drunkbatya/DrunkHeadphonesAdapter/hardware/d1/production/zip/bom.csv

Designator | Footprint | Quantity | Value | LCSC Part #
AUDIO1 | PJ-614 | 1 | PJ-614 | C145801
C10, C11, C12, C14, C15, C17, C18, C36, C38, C41, C42, C43, C45, C46, C47, C48, C6, C76, C8, C85, C93, C94 | CL05A105KA5NQNC | 22 | 1uF 25V X5R | C52923
C100, C101, C102, C103, C104, C105, C106, C107, C108, C53, C54, C55, C56, C69, C74, C77, C78, C79, C84, C86, C87, C88, C89, C90, C91, C92, C95, C96, C97, C98, C99 | 0402 | 31 | 100nF 50V | C307331
C13, C16, C2, C25, C3, C7 | 0603 | 6 | 2.2uF 16V | C23630
C19, C20, C21, C22 | 0402 | 4 | 1nF 50V | C1523
C24, C35, C37, C39, C40 | 0603 | 5 | 4.7uF 16V | C19666
C26, C27, C5, C75 | CL21A226MAQNNNE | 4 | 22uF 25V X5R | C45783
C28, C29, C30 | 0603 | 3 | 330pF 50V | C1664
C31, C32, C4 | CC0805KKX7R9BB225 | 3 | 2.2uF 50V X7R | C125847
C49 | 0402 | 1 | 10nF 50V X7R | C15195
C51, C57, C58, C59, C60, C61, C62, C9 | 1206 | 8 | 47uF 25V X5R | C76659
C64, C65, C67, C68 | 1206 | 4 | 2.2uF 50V X7R | C50254
D1, D2, D3 | D_SOD-123F | 3 | PMEG4010CEH_115 | C193342
D4 | TPD4E1B06DCKR | 1 | TPD4E1B06DCKR | C840093
L1, L3, L4, L5, L6 | BLM15AG601SN1D | 5 | BLM15AG601SN1D | C76884
L2 | SWPA4020S150MT | 1 | SWPA4020S150MT | C36407
L7, L8 | ECMF02-2AMX6 | 2 | ECMF02-2AMX6 | C2651144
Q1, Q2 | CSD17577Q3A | 2 | CSD17577Q3A | C201632
Q3 | SOT-523 | 1 | DMG1012T-7 | C20512
R1 | 1206 | 1 | 100Ω 1206 | C874066
R10, R13, R22, R29 | 0402 | 4 | 10kΩ | C25744
R11, R12 | 0402 | 2 | 2.2kΩ | C25879
R14, R15, R31, R32, R33, R34, R36, R37, R39, R4, R42, R5, R6, R7, R8 | 0402WGF1003TCE | 15 | 100kΩ | C25741
R16, R23, R9 | 0402 | 3 | 1kΩ | C11702
R18 | 0805 | 1 | 10mΩ 500mW | C409060
R19, R20 | 0603 | 2 | 549Ω | C23079
R2 | 0402WGF6202TCE | 1 | 62kΩ | C37825
R21, R28 | 0402 | 2 | 130kΩ | C93946
R24, R25, R26 | 0402 | 3 | 47kΩ | C25792
R27 | 0805 | 1 | 7mΩ 500mW | C22450691
R3 | 0402WGF2202TCE | 1 | 22kΩ | C25768
R30, R35 | 0603 | 2 | 10kΩ | C25804
R38, R43, R44 | 0402 | 3 | 33Ω | C25105
SW1 | SSSS811101 | 1 | SSSS811101 | C109335
SW3 | DSHP02TSGER | 1 | DSHP02TSGER | C3293142
TP1 | TestPoint_Pad_1.0x1.0mm | 1 | 3V3_D
TP2 | TestPoint_Pad_1.0x1.0mm | 1 | 1V8_D
TP3 | TestPoint_Pad_1.0x1.0mm | 1 | 1V8_CP
TP4 | TestPoint_Pad_1.0x1.0mm | 1 | 1V8_VA
TP5 | TestPoint_Pad_1.0x1.0mm | 1 | 3V3_VA
TP6 | TestPoint_Pad_1.0x1.0mm | 1 | 3V8
TP7 | TestPoint_Pad_1.0x1.0mm | 1 | PWR_IN
TP8 | TestPoint_Pad_1.0x1.0mm | 1 | GND
U1 | CS43131-CNZR | 1 | CS43131-CNZR | C965907
U10, U14 | BLM15PX601SN1D | 2 | BLM15PX601SN1D | C160977
U11, U8 | TPS7A2033PDBVR | 2 | TPS7A2033PDBVR | C2862740
U12, U13, U7 | TPS7A2018PDBVR | 3 | TPS7A2018PDBVR | C963430
U15, U16 | ESDA25P35-1U1M_C19829649 | 2 | ESDA25P35-1U1M | C19829649
U17 | SOT-23-5 | 1 | SN74LVC1G32DBVR | C10096
U18, U19 | TPS22917DBVR | 2 | TPS22917DBVR | C2681320
U2 | STM32G0B1VCT6 | 1 | STM32G0B1VCT6 | C3446137
U20 | SN74AVC4T774RSVR | 1 | SN74AVC4T774RSVR | C779392
U21 | TCA9406DCUR | 1 | TCA9406DCUR | C840107
U3 | TS3USB221RSER | 1 | TS3USB221RSER | C130085
U4, U5 | TCPP03-M20 | 2 | TCPP03-M20 | C3662955
U6 | ES8327 | 1 | ES8327 | C5145122
U9 | TPS560430XFDBVR | 1 | TPS560430XFDBVR | C523980
USB1 | 2130830005 | 1 | 2130830005 | C2839029
X1 | SX2M22_5792M20F30TNN | 1 | 22.5792MHz | C5452663
X3 | SX2M22_5792M20F30TNN | 1 | 24.576MHz | C5452664
