drunkbatya/DrunkHeadphonesAdapter/hardware/d1/DrunkEarPhoneAdapter.pdf

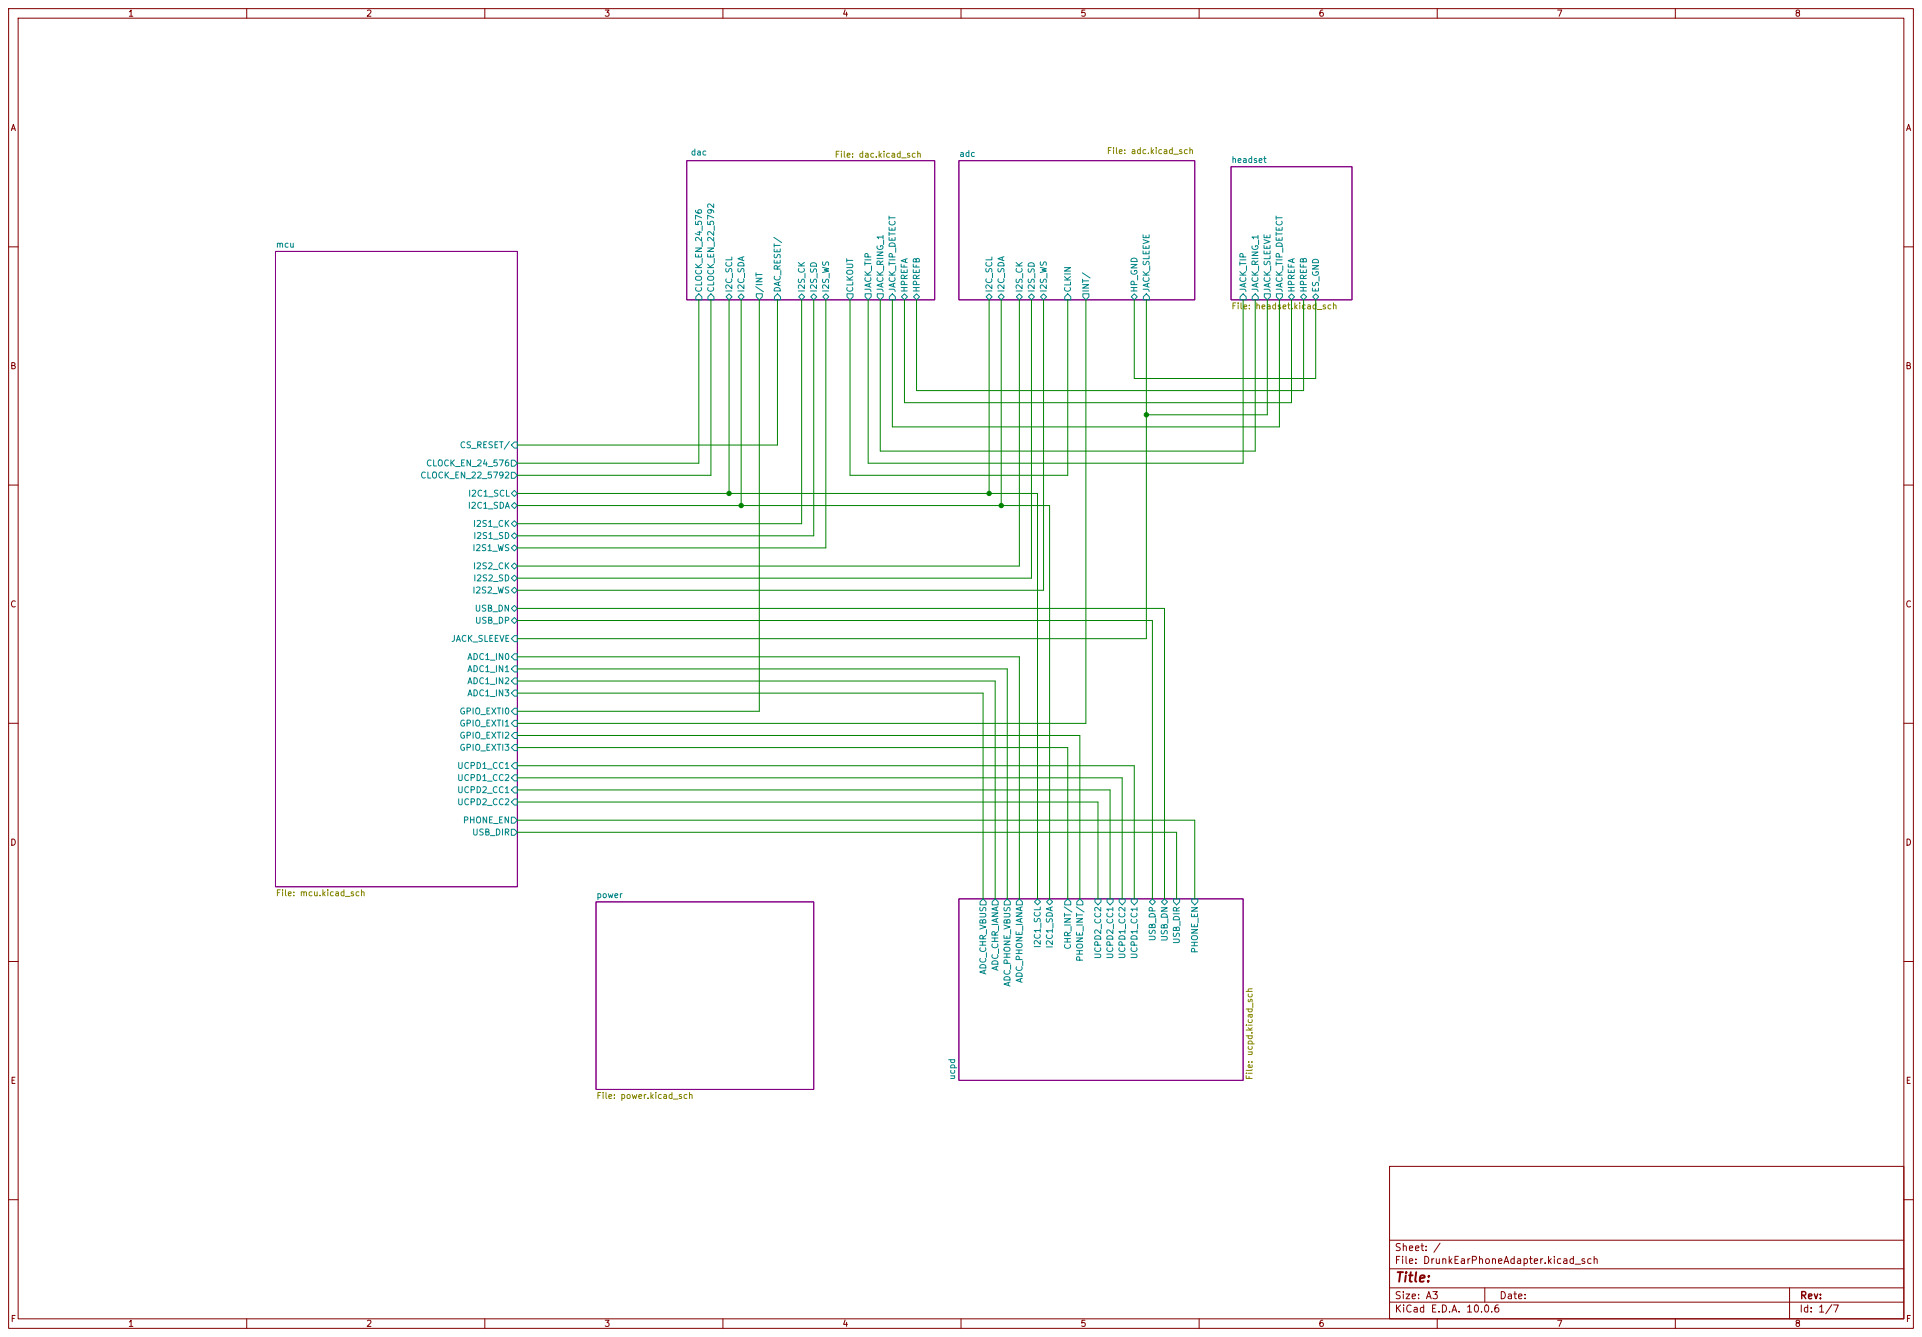
[picture p1: page 1]

Size: A3 | Rev: | F Date:
KiCad E.D.A. 10.0.6 | Id: 1/7

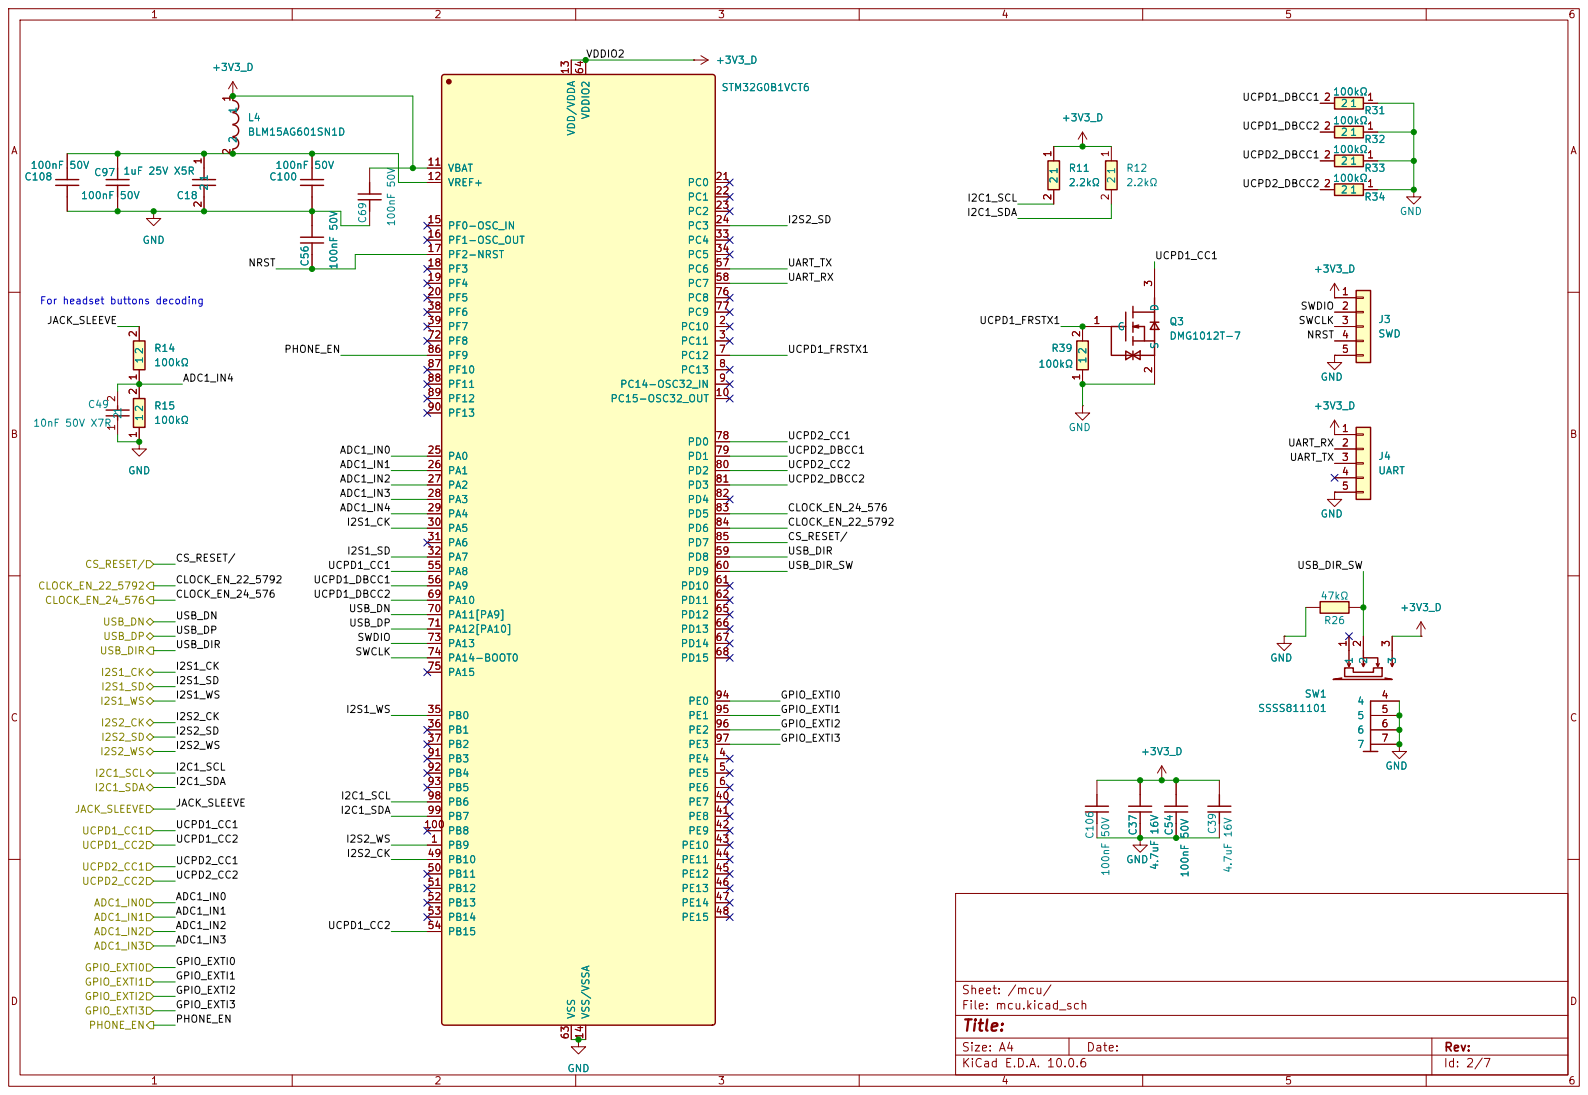
[picture p2: page 2]

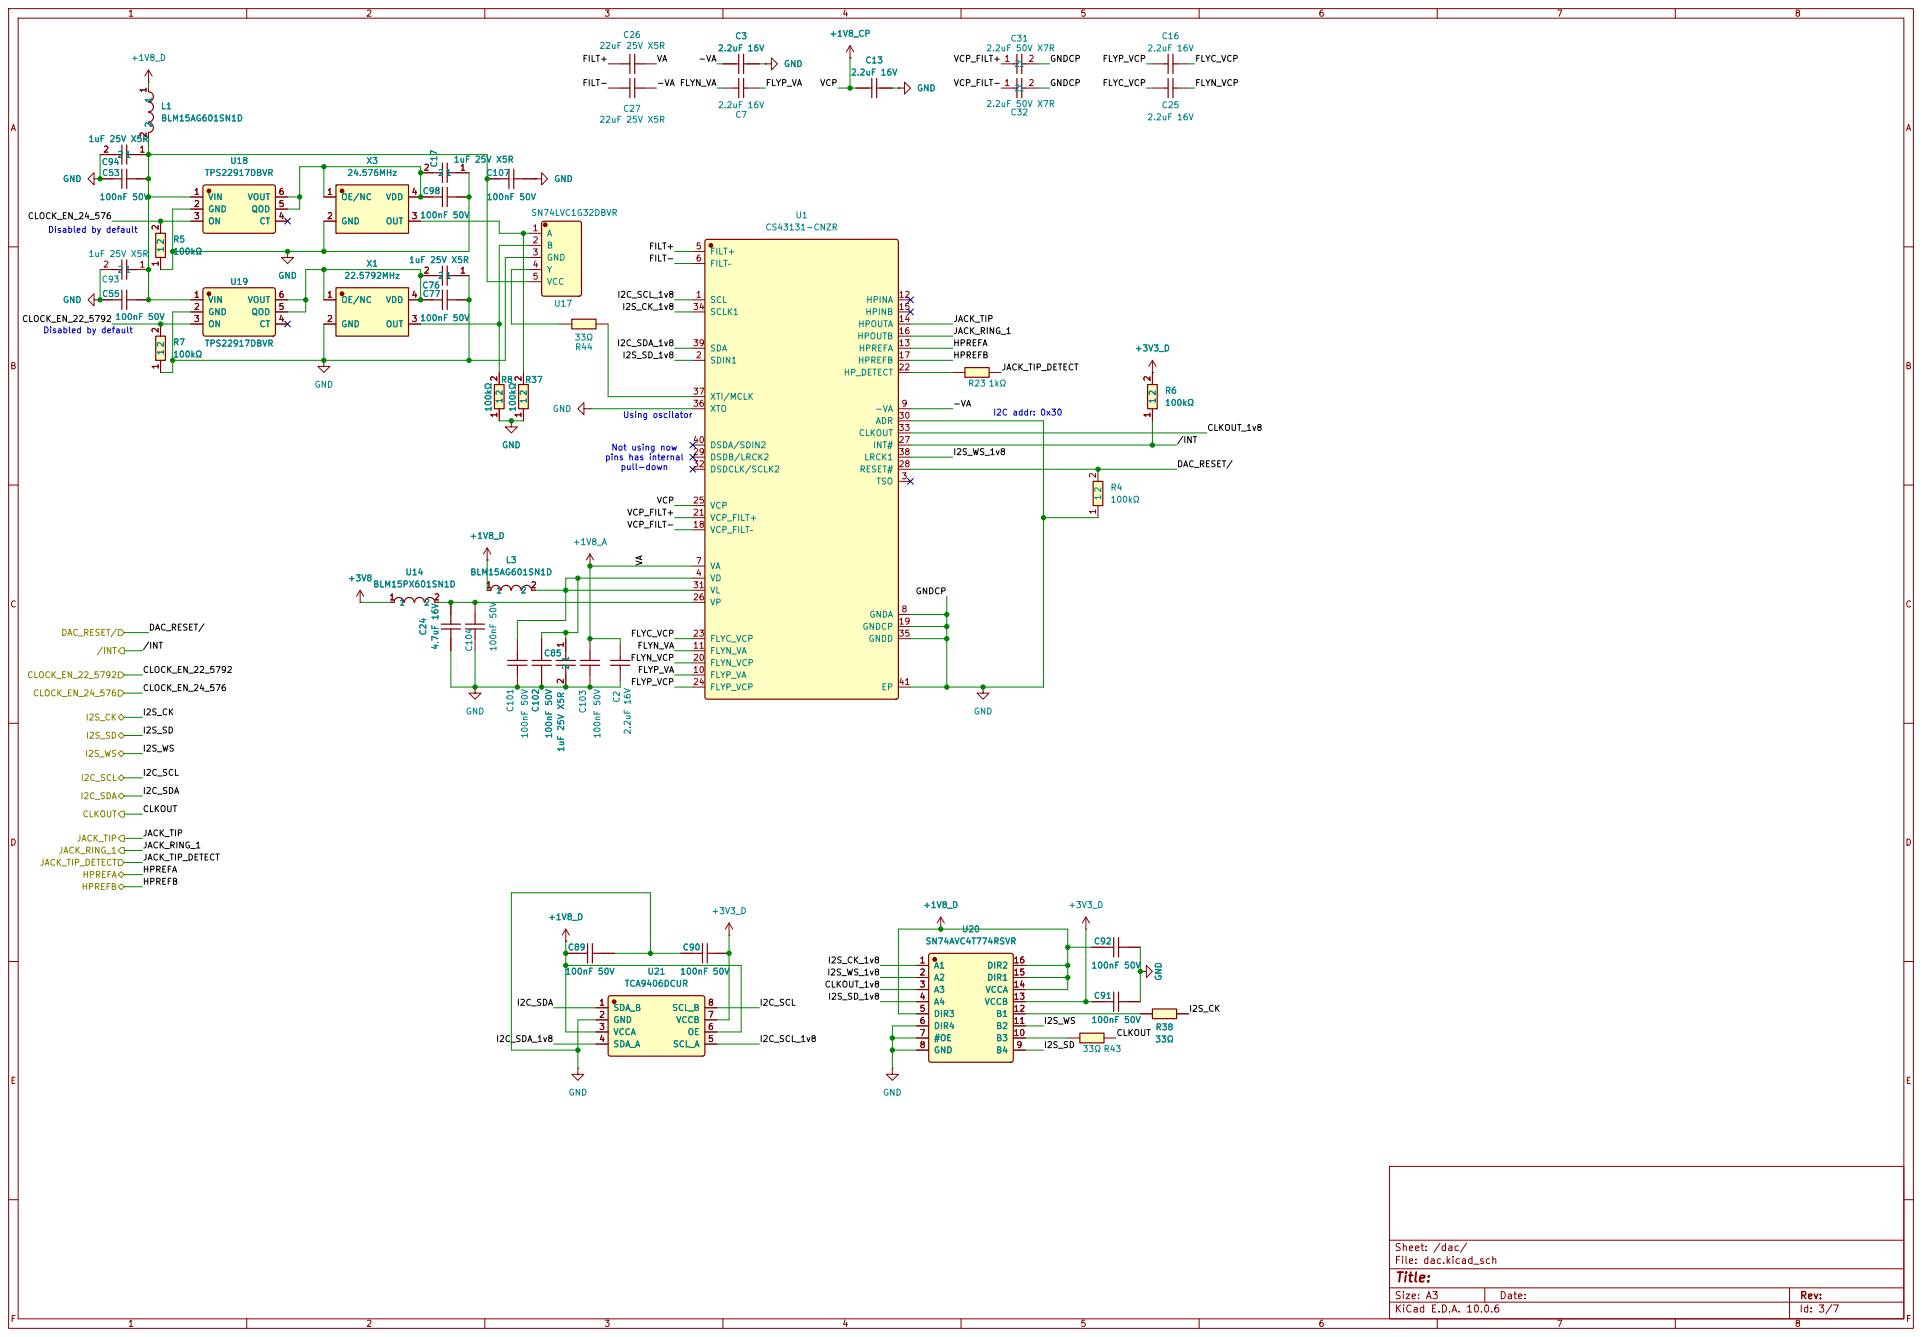
[picture p3: page 3]

pins has internal pull-down

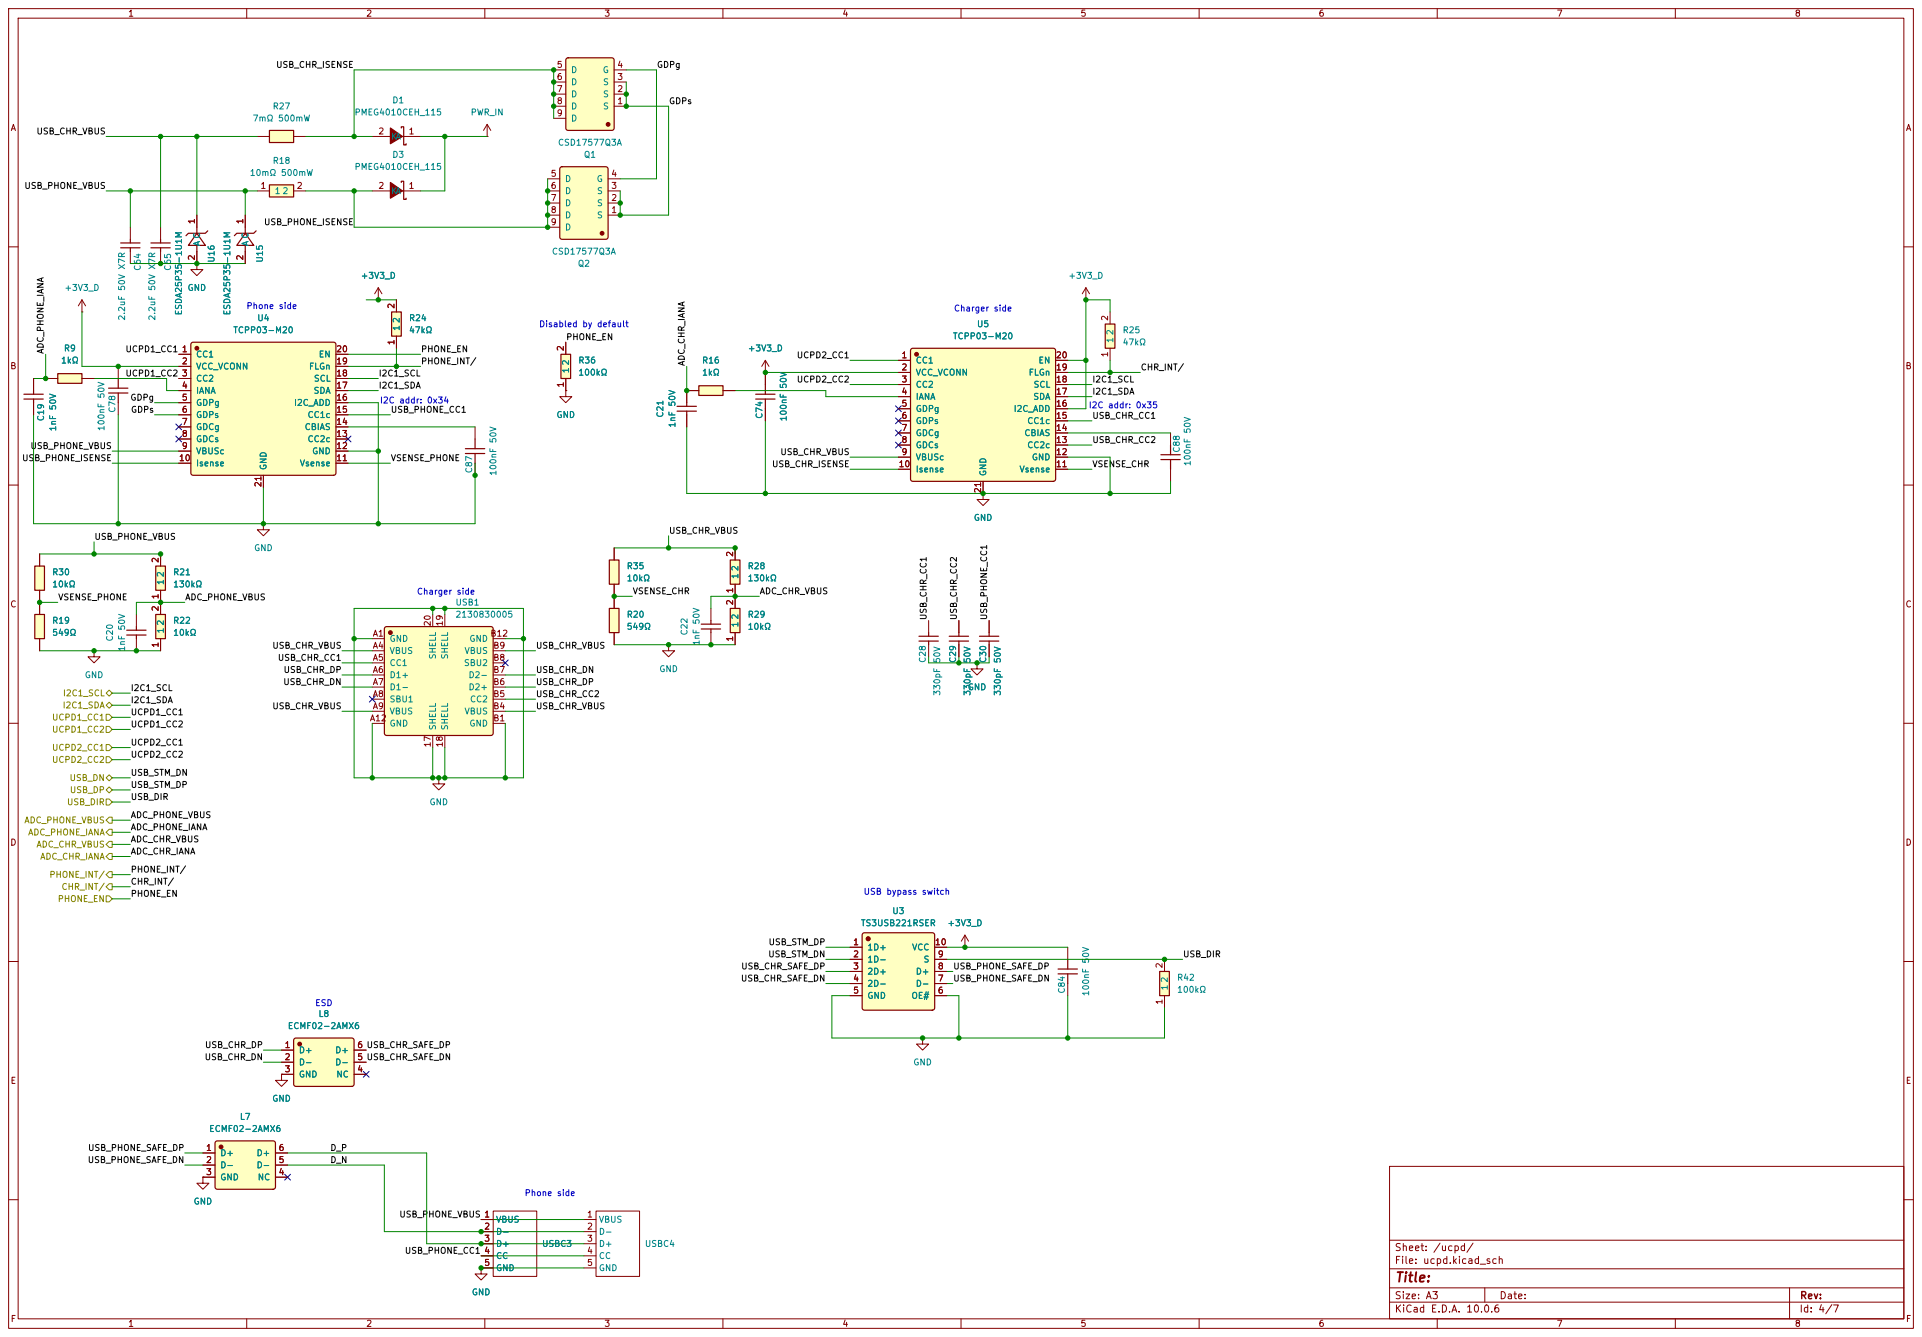
[picture p4: page 4]

Charger side Charger side Phone side

IANA 4 GDPg 5 GDPs 6 GDCg 7 GDCs 8

I2C addr: 0x35 USB bypass switch

VBUS 1 D- 2 D+ 3 CC 4 GND 5

USBC3

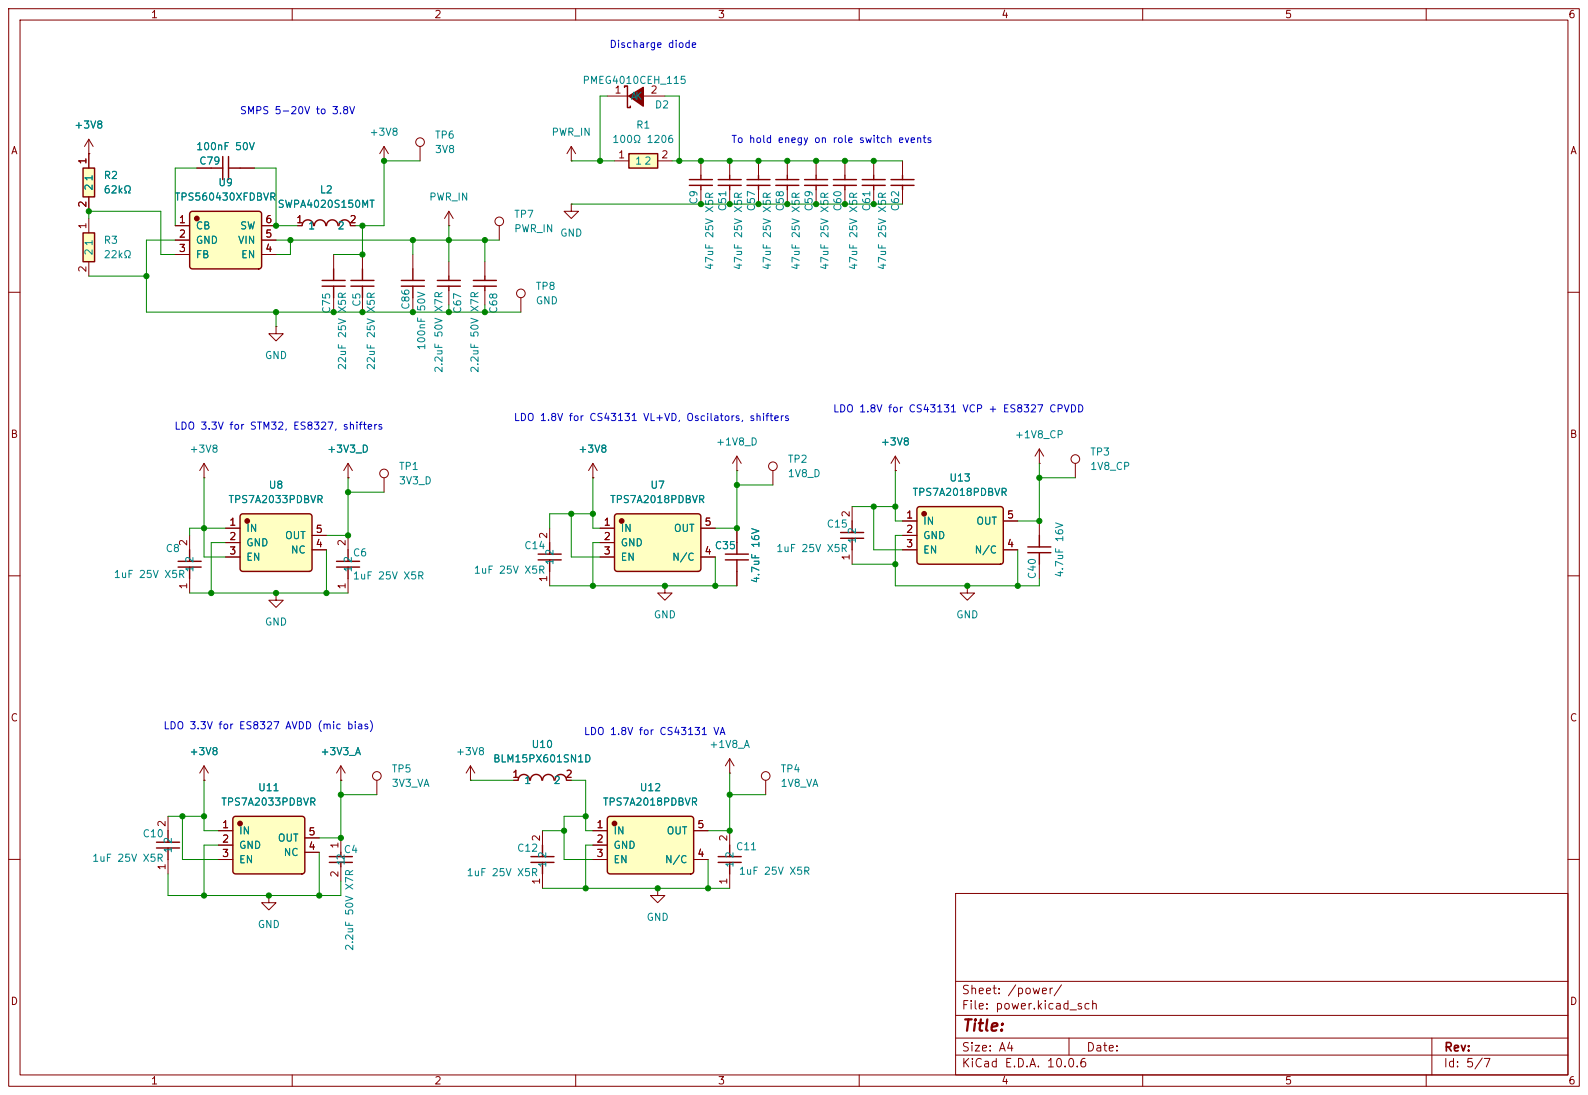
[picture p5: page 5]

LDO 1.8V for CS43131 VCP + ES8327 CPVDD

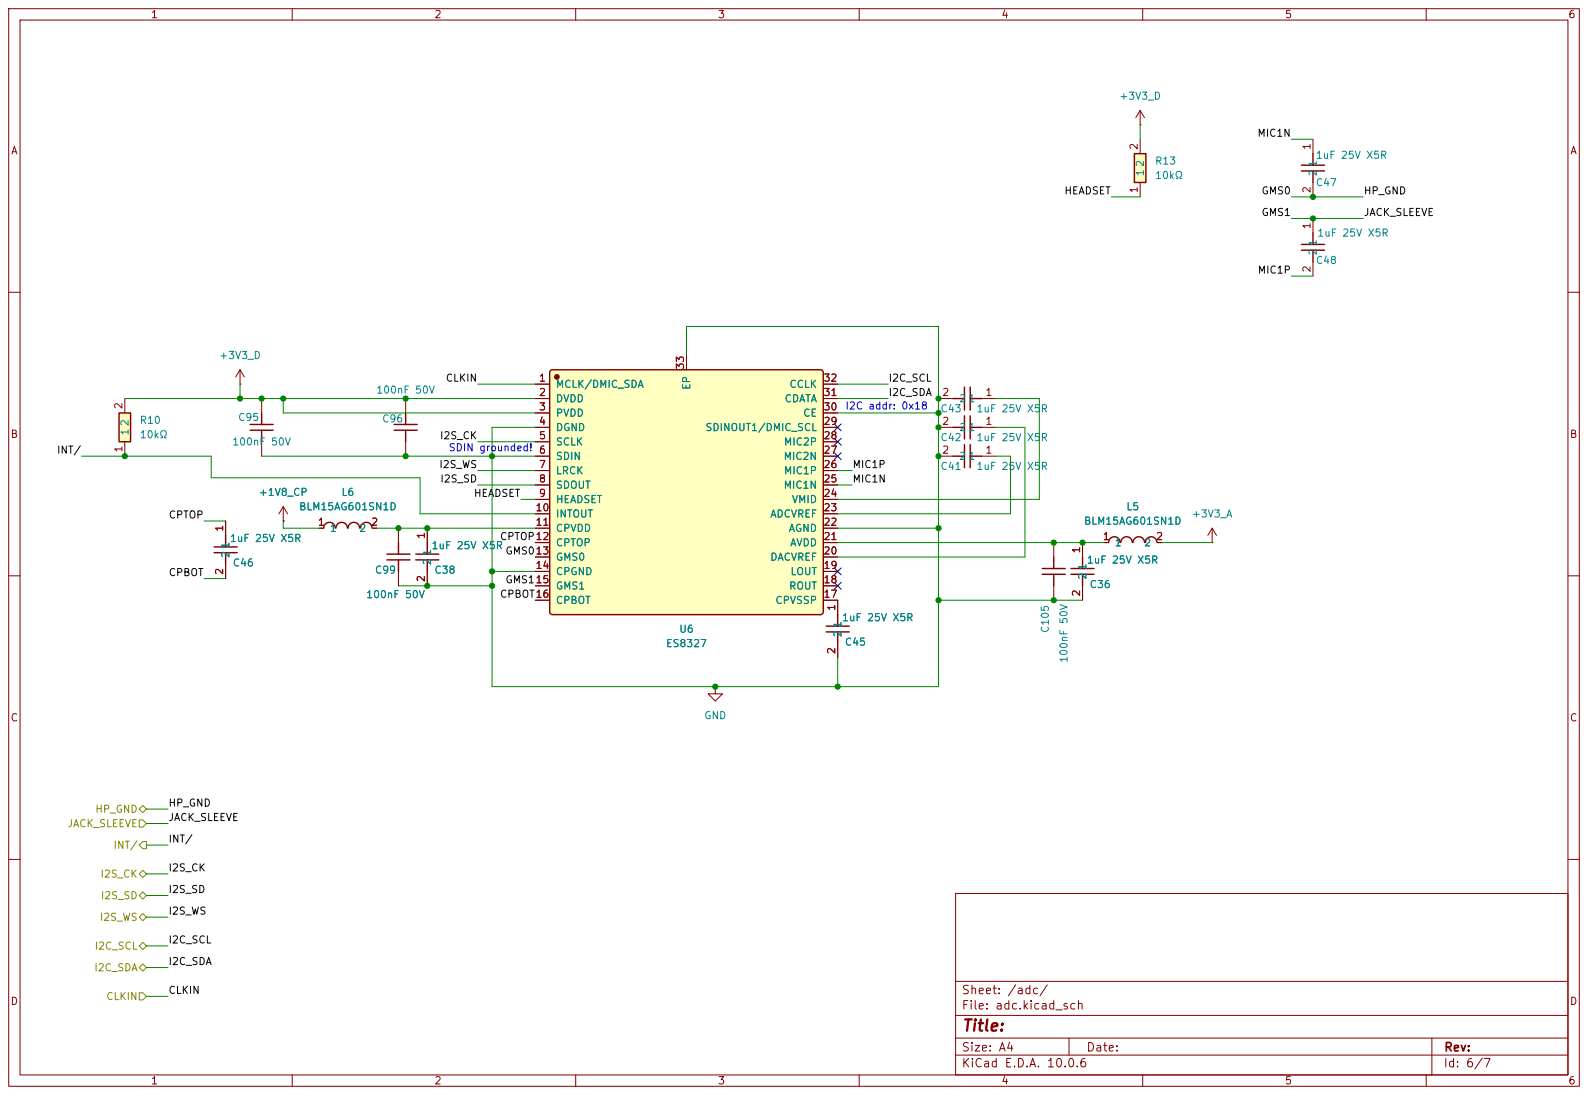
[picture p6: page 6]

MCLK/DMIC_SDA 1 DVDD 2 PVDD 3 DGND 4

ES8327 MCLK/DMIC_SDA 1 DVDD 2 PVDD 3 DGND 4

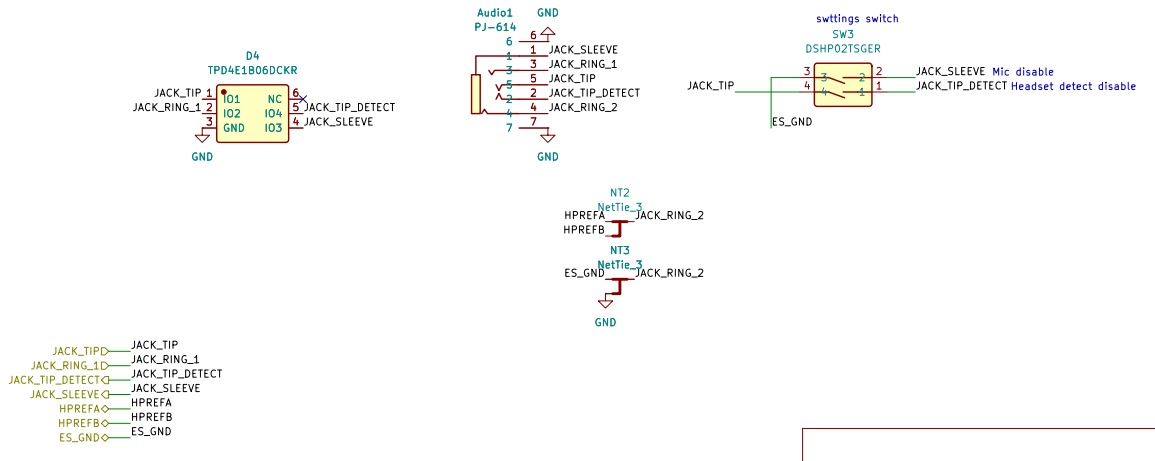
[picture p7: page 7]
