drunkbatya/DrunkHeadphonesAdapter/hardware/d1/DrunkEarPhoneAdapter.kicad_pcb

## KiCad design hardware/d1/DrunkEarPhoneAdapter.kicad_pcb (2026-11-13)

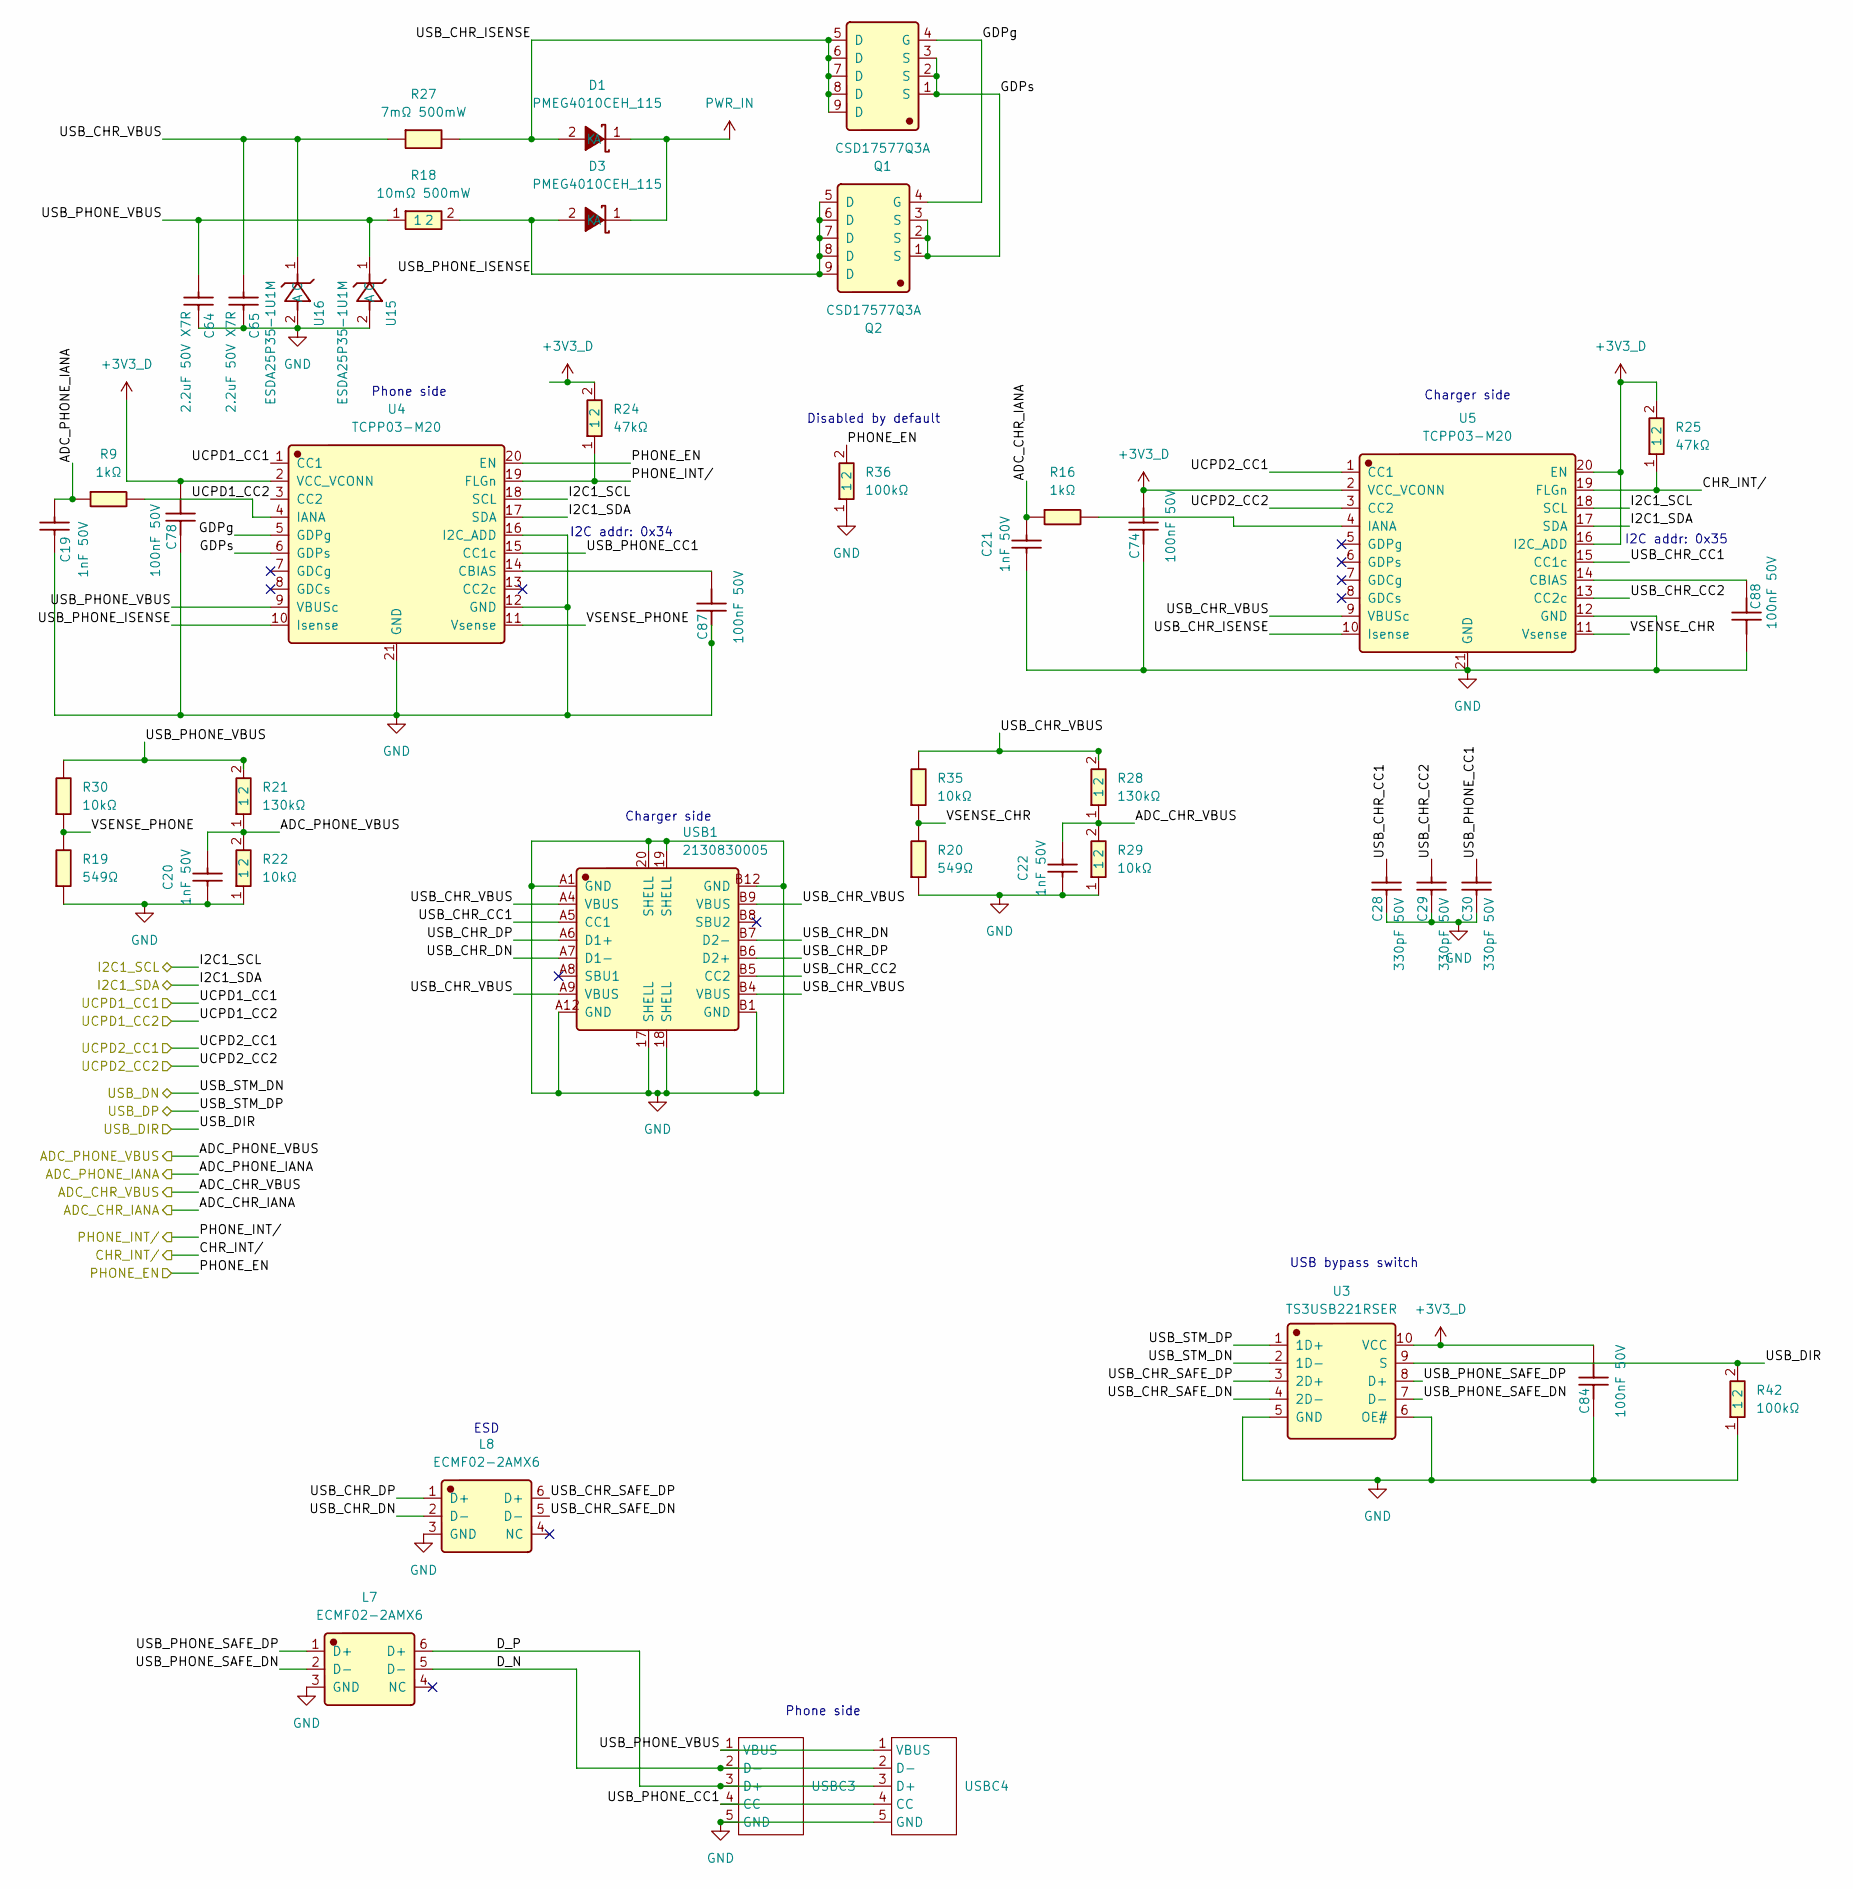
[picture p8: schematic ucpd.kicad_sch]

Parts:
C19, C20, C21, C22: 1nF 50V; C_0402_1005Metric; Manufacturer Part 0402B102K500NT; LCSC C1523
C28, C29, C30: 330pF 50V; C_0603_1608Metric; Manufacturer Part CL10C331JB8NNNC; LCSC C1664
C64, C65: 2.2uF 50V X7R; C_1206_3216Metric; Manufacturer Part CL31B225KBHNNNE; LCSC C50254
C74, C78, C84, C87, C88: 100nF 50V; C_0402_1005Metric; Manufacturer Part CL05B104KB54PNC; LCSC C307331
D1, D3: PMEG4010CEH_115; D_SOD-123F; Manufacturer Part PMEG4010CEH,115; LCSC C193342
L7, L8: ECMF02-2AMX6; Manufacturer Part ECMF02-2AMX6; LCSC C2651144
Q1, Q2: CSD17577Q3A; Manufacturer Part CSD17577Q3A; LCSC C201632
R9, R16: 1kΩ; R_0402_1005Metric; Manufacturer Part 0402WGF1001TCE; LCSC C11702
R18: 10mΩ 500mW; R_0805_2012Metric; Manufacturer Part ERJ6BWFR010V; LCSC C409060
R19, R20: 549Ω; R_0603_1608Metric; Manufacturer Part 0603WAF5490T5E; LCSC C23079
R21, R28: 130kΩ; R_0402_1005Metric; Manufacturer Part RC0402FR-07130KL; LCSC C93946
R22, R29: 10kΩ; R_0402_1005Metric; Manufacturer Part 0402WGF1002TCE; LCSC C25744
R24, R25: 47kΩ; R_0402_1005Metric; Manufacturer Part 0402WGF4702TCE; LCSC C25792
R27: 7mΩ 500mW; R_0805_2012Metric; Manufacturer Part HoYLR0805-1/2W-7mR-1%; LCSC C22450691
R30, R35: 10kΩ; R_0603_1608Metric; Manufacturer Part 0603WAF1002T5E; LCSC C25804
R36, R42: 100kΩ; 0402WGF1003TCE; Manufacturer Part 0402WGF1003TCE; LCSC C25741
U3: TS3USB221RSER; Manufacturer Part TS3USB221RSER; LCSC C130085
U4, U5: TCPP03-M20; Manufacturer Part TCPP03-M20; LCSC C3662955
U15, U16: ESDA25P35-1U1M; ESDA25P35-1U1M_C19829649; Manufacturer Part ESDA25P35-1U1M; LCSC C19829649
USB1: 2130830005; Manufacturer Part 2130830005; LCSC C2839029
USBC3, USBC4: USBC_EXT_5P

Connections:
+3V3_D: C74.2, C78.2, C84.2, R24.2, R25.2, U3.10 (VCC), U4.2 (VCC_VCONN), U5.2 (VCC_VCONN), U5.16 (I2C_ADD), U5.20 (EN); also elsewhere on the board
/adc/I2C_SCL: U4.18 (SCL), U5.18 (SCL); also elsewhere on the board
/adc/I2C_SDA: U4.17 (SDA), U5.17 (SDA); also elsewhere on the board
/mcu/ADC1_IN0: C19.2, R9.1; also elsewhere on the board
/mcu/ADC1_IN1: C20.2, R21.1, R22.2; also elsewhere on the board
/mcu/ADC1_IN2: C21.2, R16.1; also elsewhere on the board
/mcu/ADC1_IN3: C22.2, R28.1, R29.2; also elsewhere on the board
/mcu/GPIO_EXTI2: R24.1, U4.19 (FLGn); also elsewhere on the board
/mcu/GPIO_EXTI3: R25.1, U5.19 (FLGn); also elsewhere on the board
/mcu/PHONE_EN: R36.2, U4.20 (EN); also elsewhere on the board
/mcu/UCPD1_CC1: U4.1 (CC1); also elsewhere on the board
/mcu/UCPD1_CC2: U4.3 (CC2); also elsewhere on the board
/mcu/UCPD2_CC1: U5.1 (CC1); also elsewhere on the board
/mcu/UCPD2_CC2: U5.3 (CC2); also elsewhere on the board
/mcu/USB_DIR: R42.2, U3.9 (S); also elsewhere on the board
/mcu/USB_DN: U3.2 (1D-); also elsewhere on the board
/mcu/USB_DP: U3.1 (1D+); also elsewhere on the board
/ucpd/D_N: L7.5 (D-), USBC3.2 (D-), USBC4.2 (D-)
/ucpd/D_P: L7.6 (D+), USBC3.3 (D+), USBC4.3 (D+)
/ucpd/GDPg: Q1.4 (G), Q2.4 (G), U4.5 (GDPg)
/ucpd/GDPs: Q1.1 (S), Q1.2 (S), Q1.3 (S), Q2.1 (S), Q2.2 (S), Q2.3 (S), U4.6 (GDPs)
/ucpd/USB_CHR_CC1: C28.2, U5.15 (CC1c), USB1.A5 (CC1)
/ucpd/USB_CHR_CC2: C29.2, U5.13 (CC2c), USB1.B5 (CC2)
/ucpd/USB_CHR_DN: L8.2 (D-), USB1.A7 (D1-), USB1.B7 (D2-)
/ucpd/USB_CHR_DP: L8.1 (D+), USB1.A6 (D1+), USB1.B6 (D2+)
/ucpd/USB_CHR_ISENSE: D1.2 (A), Q1.5 (D), Q1.6 (D), Q1.7 (D), Q1.8 (D), Q1.9 (D), R27.2, U5.10 (Isense)
/ucpd/USB_CHR_SAFE_DN: L8.5 (D-), U3.4 (2D-)
/ucpd/USB_CHR_SAFE_DP: L8.6 (D+), U3.3 (2D+)
/ucpd/USB_CHR_VBUS: C65.2, R27.1, R28.2, R35.2, U5.9 (VBUSc), U16.1 (C), USB1.A4 (VBUS), USB1.A9 (VBUS), USB1.B4 (VBUS), USB1.B9 (VBUS)
/ucpd/USB_PHONE_CC1: C30.2, U4.15 (CC1c), USBC3.4 (CC), USBC4.4 (CC)
/ucpd/USB_PHONE_ISENSE: D3.2 (A), Q2.5 (D), Q2.6 (D), Q2.7 (D), Q2.8 (D), Q2.9 (D), R18.2, U4.10 (Isense)
/ucpd/USB_PHONE_SAFE_DN: L7.2 (D-), U3.7 (D-)
/ucpd/USB_PHONE_SAFE_DP: L7.1 (D+), U3.8 (D+)
/ucpd/USB_PHONE_VBUS: C64.2, R18.1, R21.2, R30.2, U4.9 (VBUSc), U15.1 (C), USBC3.1 (VBUS), USBC4.1 (VBUS)
/ucpd/VSENSE_CHR: R20.2, R35.1, U5.11 (Vsense)
/ucpd/VSENSE_PHONE: R19.2, R30.1, U4.11 (Vsense)
GND: C19.1, C20.1, C21.1, C22.1, C28.1, C29.1, C30.1, C64.1, C65.1, C74.1, C78.1, C84.1, C87.1, C88.2, L7.3 (GND), L8.3 (GND), R19.1, R20.1, R22.1, R29.1, R36.1, R42.1, U3.5 (GND), U3.6 (OE#), U4.12 (GND), U4.16 (I2C_ADD), U4.21 (GND), U5.12 (GND), U5.21 (GND), U15.2 (A), U16.2 (A), USB1.17 (SHELL), USB1.18 (SHELL), USB1.19 (SHELL), USB1.20 (SHELL), USB1.A1 (GND), USB1.A12 (GND), USB1.B1 (GND), USB1.B12 (GND), USBC3.5 (GND), USBC4.5 (GND); also elsewhere on the board
unnamed: C87.2, U4.14 (CBIAS)
unnamed: R9.2, U4.4 (IANA)
unnamed: C88.1, U5.14 (CBIAS)
unnamed: R16.2, U5.4 (IANA)
PWR_IN: D1.1 (K), D3.1 (K); also elsewhere on the board

Notes on the sheet:
I2C addr: 0x34
Charger side
I2C addr: 0x35
Disabled by default
USB bypass switch
Phone side
ESD

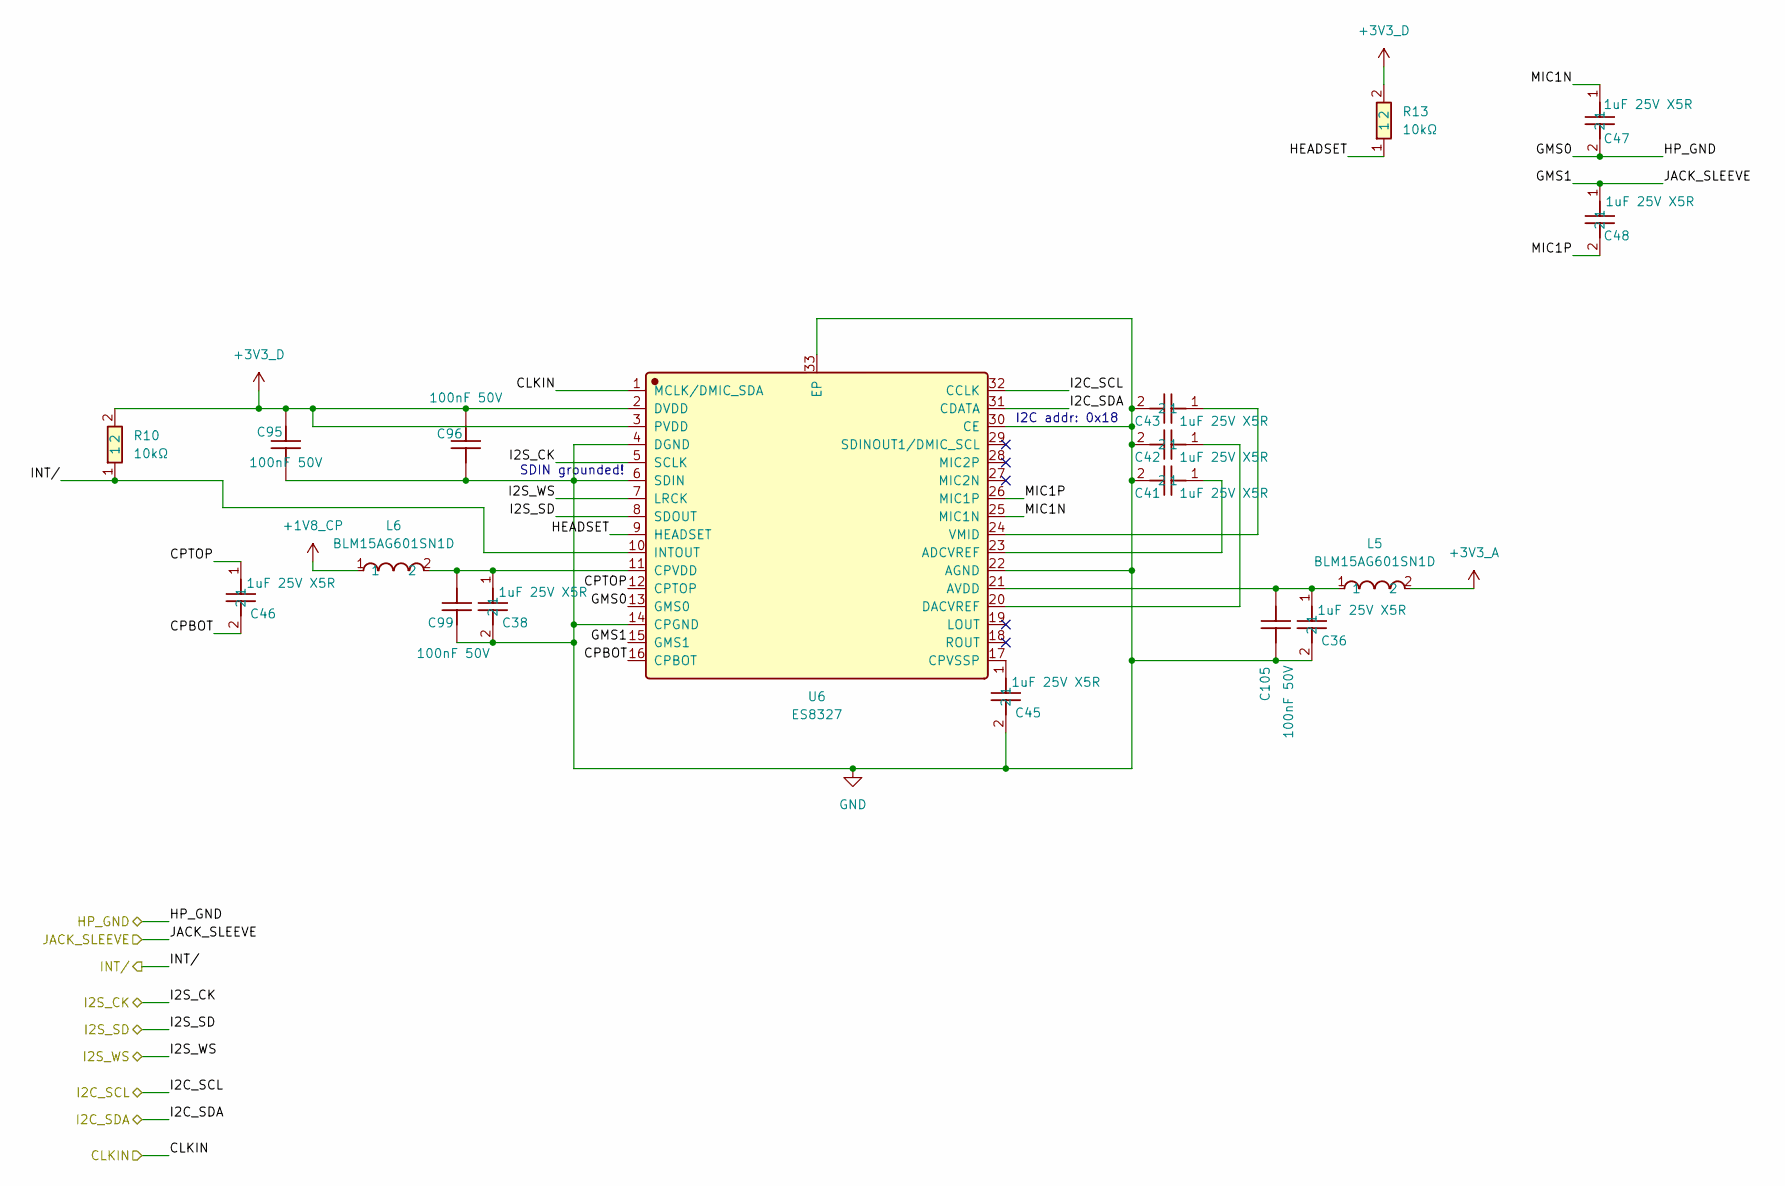
[picture p9: schematic adc.kicad_sch]

Parts:
C36, C38, C41, C42, C43, C45, C46, C47, C48: 1uF 25V X5R; CL05A105KA5NQNC; Manufacturer Part CL05A105KA5NQNC; LCSC C52923
C95, C96, C99, C105: 100nF 50V; C_0402_1005Metric; Manufacturer Part CL05B104KB54PNC; LCSC C307331
L5, L6: BLM15AG601SN1D; Manufacturer Part BLM15AG601SN1D; LCSC C76884
R10, R13: 10kΩ; R_0402_1005Metric; Manufacturer Part 0402WGF1002TCE; LCSC C25744
U6: ES8327; Manufacturer Part ES8327; LCSC C5145122

Connections:
+1V8_CP: L6.1; also elsewhere on the board
+3V3_A: L5.2; also elsewhere on the board
+3V3_D: C95.2, C96.2, R10.2, R13.2, U6.2 (DVDD), U6.3 (PVDD); also elsewhere on the board
/adc/CLKIN: U6.1 (MCLK/DMIC_SDA); also elsewhere on the board
/adc/CPBOT: C46.2, U6.16 (CPBOT)
/adc/CPTOP: C46.1, U6.12 (CPTOP)
/adc/GMS0: C47.2, U6.13 (GMS0); also elsewhere on the board
/adc/GMS1: C48.1, U6.15 (GMS1); also elsewhere on the board
/adc/HEADSET: R13.1, U6.9 (HEADSET)
/adc/I2C_SCL: U6.32 (CCLK); also elsewhere on the board
/adc/I2C_SDA: U6.31 (CDATA); also elsewhere on the board
/adc/I2S_CK: U6.5 (SCLK); also elsewhere on the board
/adc/I2S_SD: U6.8 (SDOUT); also elsewhere on the board
/adc/I2S_WS: U6.7 (LRCK); also elsewhere on the board
/adc/INT/: R10.1, U6.10 (INTOUT); also elsewhere on the board
/adc/MIC1N: C47.1, U6.25 (MIC1N)
/adc/MIC1P: C48.2, U6.26 (MIC1P)
GND: C36.2, C38.2, C41.2, C42.2, C43.2, C45.2, C95.1, C96.1, C99.1, C105.1, U6.4 (DGND), U6.6 (SDIN), U6.14 (CPGND), U6.22 (AGND), U6.30 (CE), U6.33 (EP); also elsewhere on the board
unnamed: C41.1, U6.23 (ADCVREF)
unnamed: C36.1, C105.2, L5.1, U6.21 (AVDD)
unnamed: C38.1, C99.2, L6.2, U6.11 (CPVDD)
unnamed: C45.1, U6.17 (CPVSSP)
unnamed: C42.1, U6.20 (DACVREF)
unnamed: C43.1, U6.24 (VMID)

Notes on the sheet:
SDIN grounded!
I2C addr: 0x18

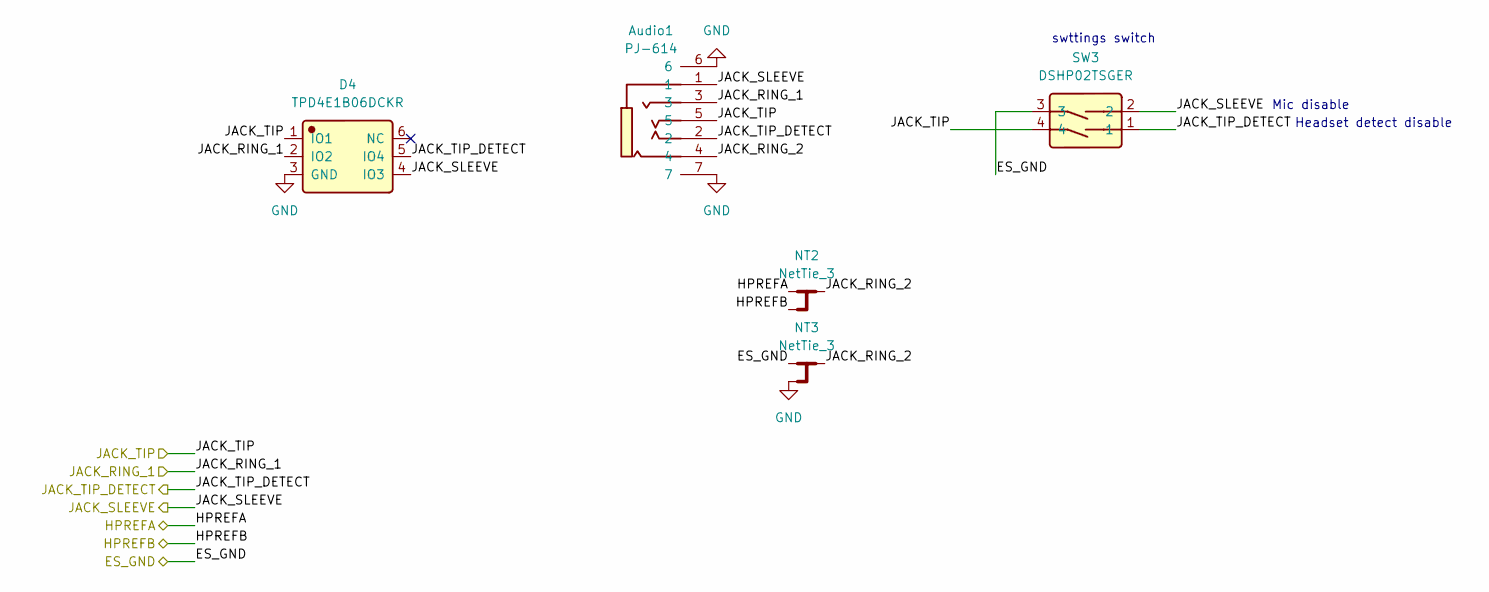
[picture p10: schematic headset.kicad_sch]

Parts:
Audio1: PJ-614; Manufacturer Part PJ-614; LCSC C145801
D4: TPD4E1B06DCKR; Manufacturer Part TPD4E1B06DCKR; LCSC C840093
NT2, NT3: NetTie_3; NetTie-3_SMD_Pad0.5mm
SW3: DSHP02TSGER; Manufacturer Part DSHP02TSGER; LCSC C3293142

Connections:
/adc/GMS0: NT3.1, SW3.3; also elsewhere on the board
/adc/GMS1: Audio1.1, D4.4 (IO3), SW3.2; also elsewhere on the board
/dac/HPREFA: NT2.1; also elsewhere on the board
/dac/HPREFB: NT2.3; also elsewhere on the board
/dac/JACK_RING_1: Audio1.3, D4.2 (IO2); also elsewhere on the board
/dac/JACK_TIP: Audio1.5, D4.1 (IO1), SW3.4; also elsewhere on the board
/dac/JACK_TIP_DETECT: Audio1.2, D4.5 (IO4), SW3.1; also elsewhere on the board
/headset/JACK_RING_2: Audio1.4, NT2.2, NT3.2
GND: Audio1.6, Audio1.7, D4.3 (GND), NT3.3; also elsewhere on the board

Notes on the sheet:
Headset detect disable
swttings switch
Mic disable

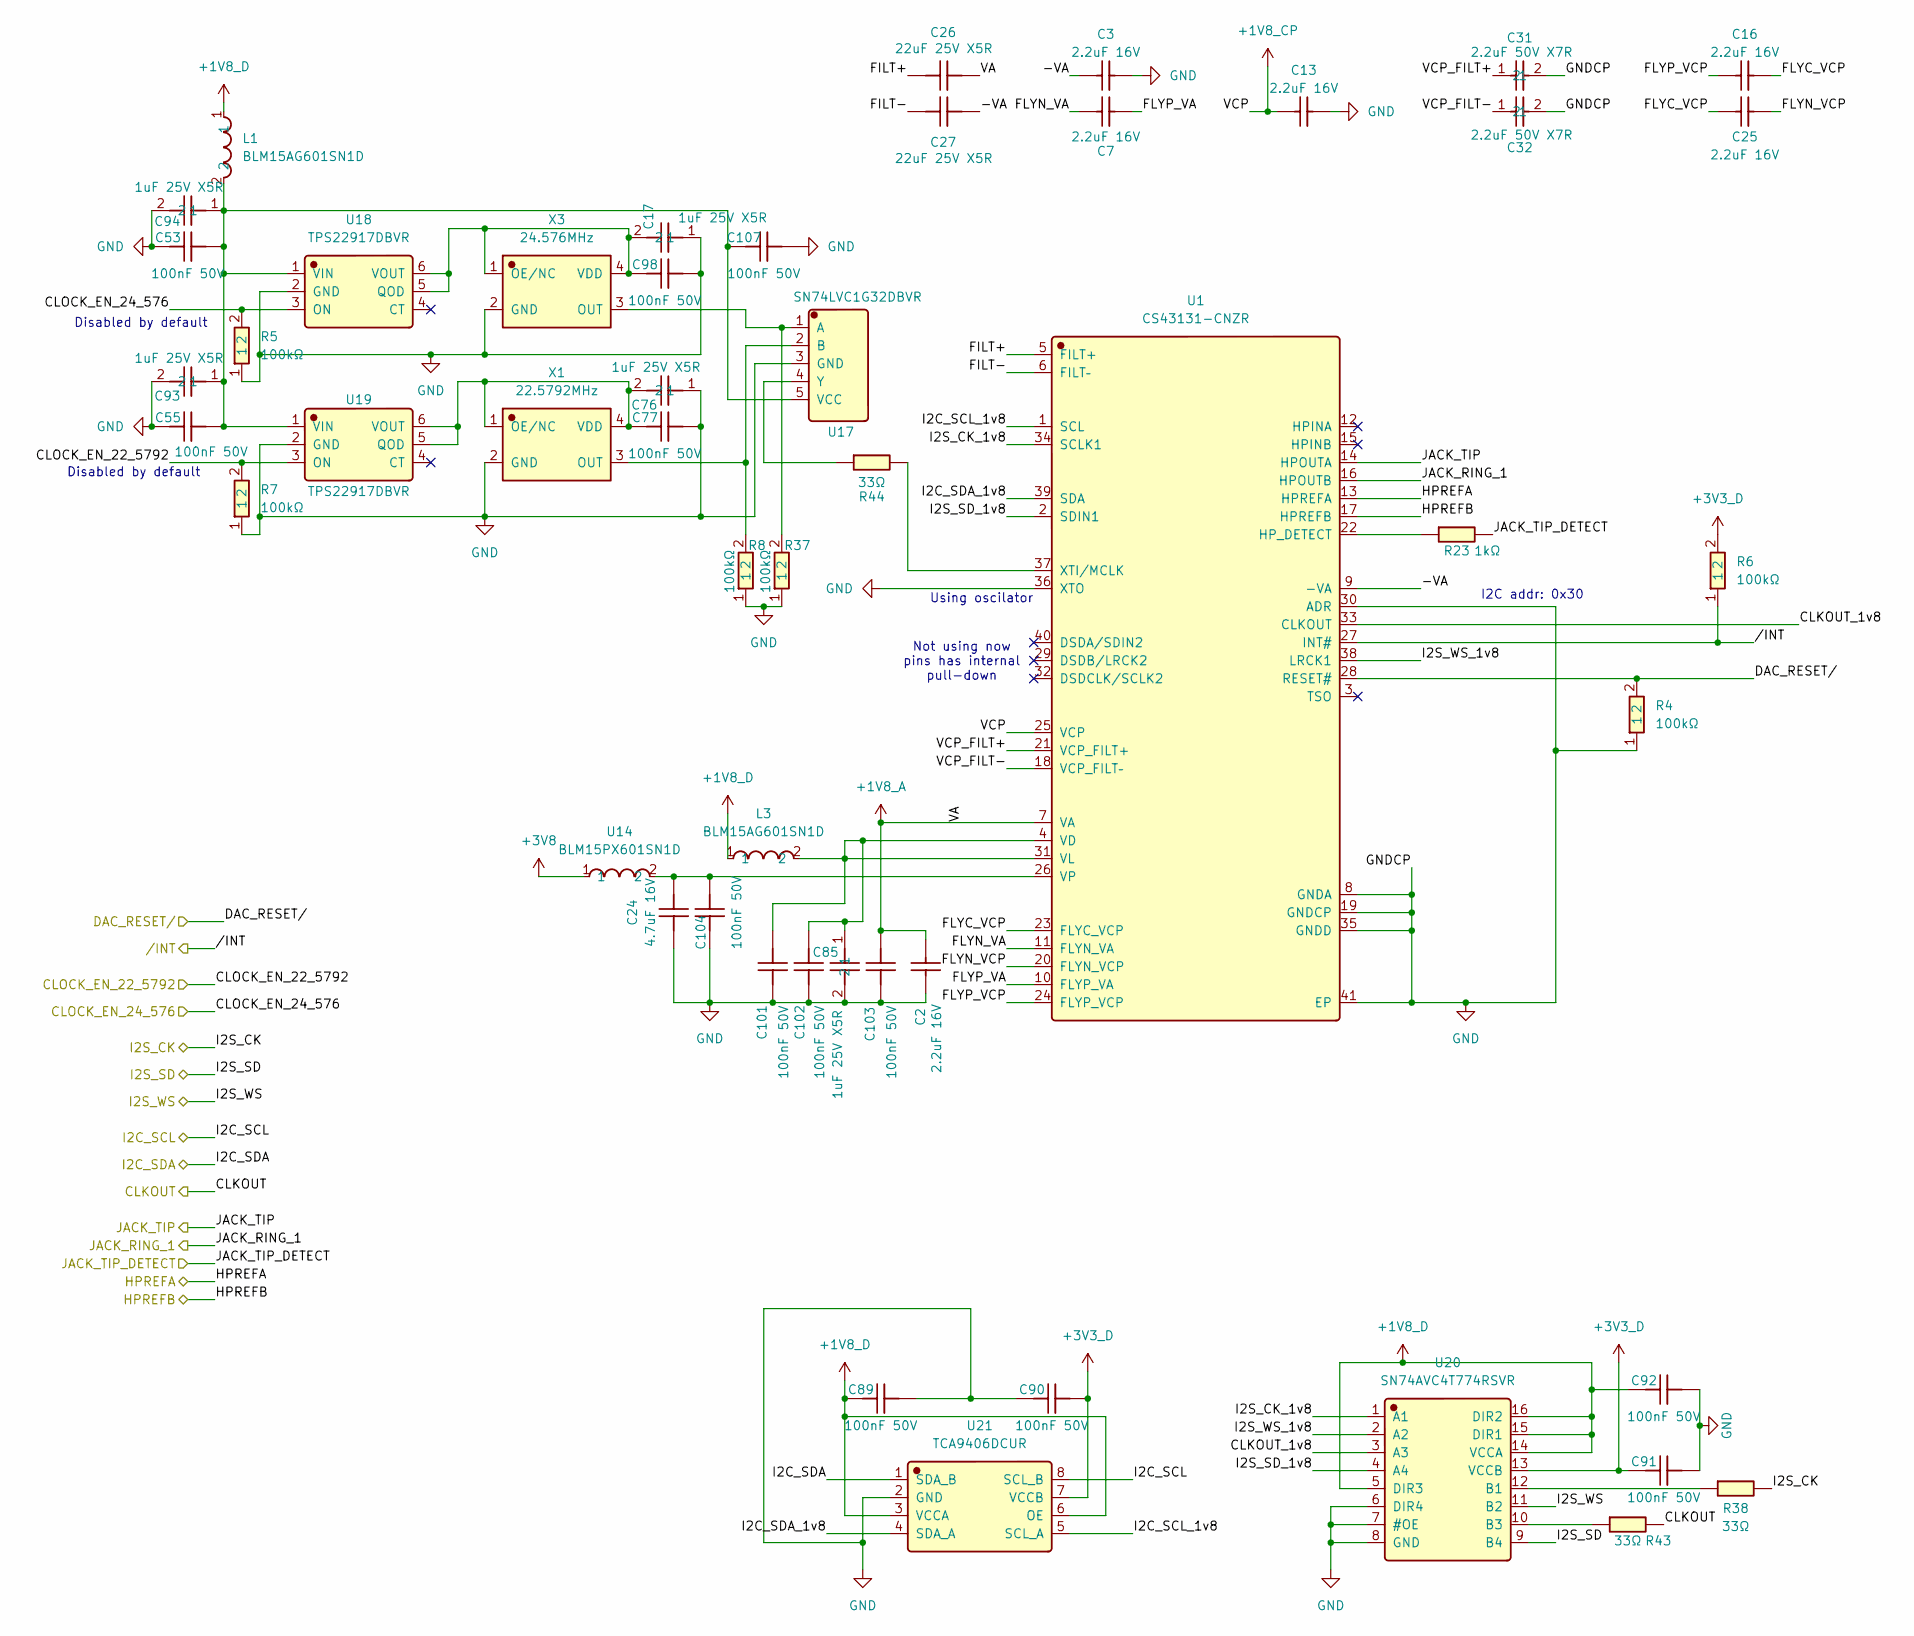
[picture p11: schematic dac.kicad_sch]

Parts:
C2, C3, C7, C13, C16, C25: 2.2uF 16V; C_0603_1608Metric; Manufacturer Part CL10A225KO8NNNC; LCSC C23630
C17, C76, C85, C93, C94: 1uF 25V X5R; CL05A105KA5NQNC; Manufacturer Part CL05A105KA5NQNC; LCSC C52923
C24: 4.7uF 16V; C_0603_1608Metric; Manufacturer Part CL10A475KO8NNNC; LCSC C19666
C26, C27: 22uF 25V X5R; CL21A226MAQNNNE; Manufacturer Part CL21A226MAQNNNE; LCSC C45783
C31, C32: 2.2uF 50V X7R; CC0805KKX7R9BB225; Manufacturer Part CC0805KKX7R9BB225; LCSC C125847
C53, C55, C77, C89, C90, C91, C92, C98, C101, C102, C103, C104, C107: 100nF 50V; C_0402_1005Metric; Manufacturer Part CL05B104KB54PNC; LCSC C307331
L1, L3: BLM15AG601SN1D; Manufacturer Part BLM15AG601SN1D; LCSC C76884
R4, R5, R6, R7, R8, R37: 100kΩ; 0402WGF1003TCE; Manufacturer Part 0402WGF1003TCE; LCSC C25741
R23: 1kΩ; R_0402_1005Metric; Manufacturer Part 0402WGF1001TCE; LCSC C11702
R38, R43, R44: 33Ω; R_0402_1005Metric; Manufacturer Part 0402WGF330JTCE; LCSC C25105
U1: CS43131-CNZR; Manufacturer Part CS43131-CNZR; LCSC C965907
U14: BLM15PX601SN1D; Manufacturer Part BLM15PX601SN1D; LCSC C160977
U17: SN74LVC1G32DBVR; SOT-23-5; Manufacturer Part SN74LVC1G32DBVR; LCSC C10096
U18, U19: TPS22917DBVR; Manufacturer Part TPS22917DBVR; LCSC C2681320
U20: SN74AVC4T774RSVR; Manufacturer Part SN74AVC4T774RSVR; LCSC C779392
U21: TCA9406DCUR; Manufacturer Part TCA9406DCUR; LCSC C840107
X1: 22.5792MHz; SX2M22_5792M20F30TNN; Manufacturer Part SX2M22.5792M20F30TNN; LCSC C5452663
X3: 24.576MHz; SX2M22_5792M20F30TNN; Manufacturer Part SX2M24.576M20F30TNN; LCSC C5452664

Connections:
+1V8_A: C2.2, C26.2, C103.2, U1.7 (VA); also elsewhere on the board
+1V8_CP: C13.1, U1.25 (VCP); also elsewhere on the board
+1V8_D: C89.1, C92.1, L1.1, L3.1, U20.5 (DIR3), U20.14 (VCCA), U20.15 (DIR1), U20.16 (DIR2), U21.3 (VCCA), U21.6 (OE); also elsewhere on the board
+3V3_D: C90.2, C91.1, R6.2, U20.13 (VCCB), U21.7 (VCCB); also elsewhere on the board
+3V8: U14.1; also elsewhere on the board
/adc/CLKIN: R43.2; also elsewhere on the board
/adc/I2C_SCL: U21.8 (SCL_B); also elsewhere on the board
/adc/I2C_SDA: U21.1 (SDA_B); also elsewhere on the board
/dac/-VA: C3.1, C27.2, U1.9 (-VA)
/dac/CLKOUT_1v8: U1.33 (CLKOUT), U20.3 (A3)
/dac/CLOCK_EN_22_5792: R7.2, U19.3 (ON); also elsewhere on the board
/dac/CLOCK_EN_24_576: R5.2, U18.3 (ON); also elsewhere on the board
/dac/DAC_RESET/: R4.2, U1.28 (RESET#); also elsewhere on the board
/dac/FILT+: C26.1, U1.5 (FILT+)
/dac/FILT-: C27.1, U1.6 (FILT–)
/dac/FLYC_VCP: C16.2, C25.1, U1.23 (FLYC_VCP)
/dac/FLYN_VA: C7.1, U1.11 (FLYN_VA)
/dac/FLYN_VCP: C25.2, U1.20 (FLYN_VCP)
/dac/FLYP_VA: C7.2, U1.10 (FLYP_VA)
/dac/FLYP_VCP: C16.1, U1.24 (FLYP_VCP)
/dac/HPREFA: U1.13 (HPREFA); also elsewhere on the board
/dac/HPREFB: U1.17 (HPREFB); also elsewhere on the board
/dac/I2C_SCL_1v8: U1.1 (SCL), U21.5 (SCL_A)
/dac/I2C_SDA_1v8: U1.39 (SDA), U21.4 (SDA_A)
/dac/I2S_CK: R38.2; also elsewhere on the board
/dac/I2S_CK_1v8: U1.34 (SCLK1), U20.1 (A1)
/dac/I2S_SD: U20.9 (B4); also elsewhere on the board
/dac/I2S_SD_1v8: U1.2 (SDIN1), U20.4 (A4)
/dac/I2S_WS: U20.11 (B2); also elsewhere on the board
/dac/I2S_WS_1v8: U1.38 (LRCK1), U20.2 (A2)
/dac/JACK_RING_1: U1.16 (HPOUTB); also elsewhere on the board
/dac/JACK_TIP: U1.14 (HPOUTA); also elsewhere on the board
/dac/JACK_TIP_DETECT: R23.2; also elsewhere on the board
/dac/VCP_FILT+: C31.1, U1.21 (VCP_FILT+)
/dac/VCP_FILT-: C32.1, U1.18 (VCP_FILT–)
/dac//INT: R6.1, U1.27 (INT#); also elsewhere on the board
GND: C2.1, C3.2, C13.2, C17.1, C24.1, C31.2, C32.2, C53.1, C55.1, C76.1, C77.2, C85.2, C89.2, C90.1, C91.2, C92.2, C93.2, C94.2, C98.2, C101.1, C102.1, C103.1, C104.1, C107.2, R4.1, R5.1, R7.1, R8.1, R37.1, U1.8 (GNDA), U1.19 (GNDCP), U1.30 (ADR), U1.35 (GNDD), U1.36 (XTO), U1.41 (EP), U17.3 (GND), U18.2 (GND), U19.2 (GND), U20.6 (DIR4), U20.7 (#OE), U20.8 (GND), U21.2 (GND), X1.2 (GND), X3.2 (GND); also elsewhere on the board
unnamed: R23.1, U1.22 (HP_DETECT)
unnamed: C85.1, C101.2, C102.2, L3.2, U1.4 (VD), U1.31 (VL)
unnamed: C24.2, C104.2, U1.26 (VP), U14.2
unnamed: R44.2, U1.37 (XTI/MCLK)
unnamed: R37.2, U17.1 (A), X3.3 (OUT)
unnamed: R8.2, U17.2 (B), X1.3 (OUT)
unnamed: C53.2, C55.2, C93.1, C94.1, C107.1, L1.2, U17.5 (VCC), U18.1 (VIN), U19.1 (VIN)
unnamed: R44.1, U17.4 (Y)
unnamed: C17.2, C98.1, U18.5 (QOD), U18.6 (VOUT), X3.1 (OE/NC), X3.4 (VDD)
unnamed: C76.2, C77.1, U19.5 (QOD), U19.6 (VOUT), X1.1 (OE/NC), X1.4 (VDD)
unnamed: R38.1, U20.12 (B1)
unnamed: R43.1, U20.10 (B3)

Notes on the sheet:
I2C addr: 0x30
Using oscilator
Not using now pins has internal pull-down
Disabled by default

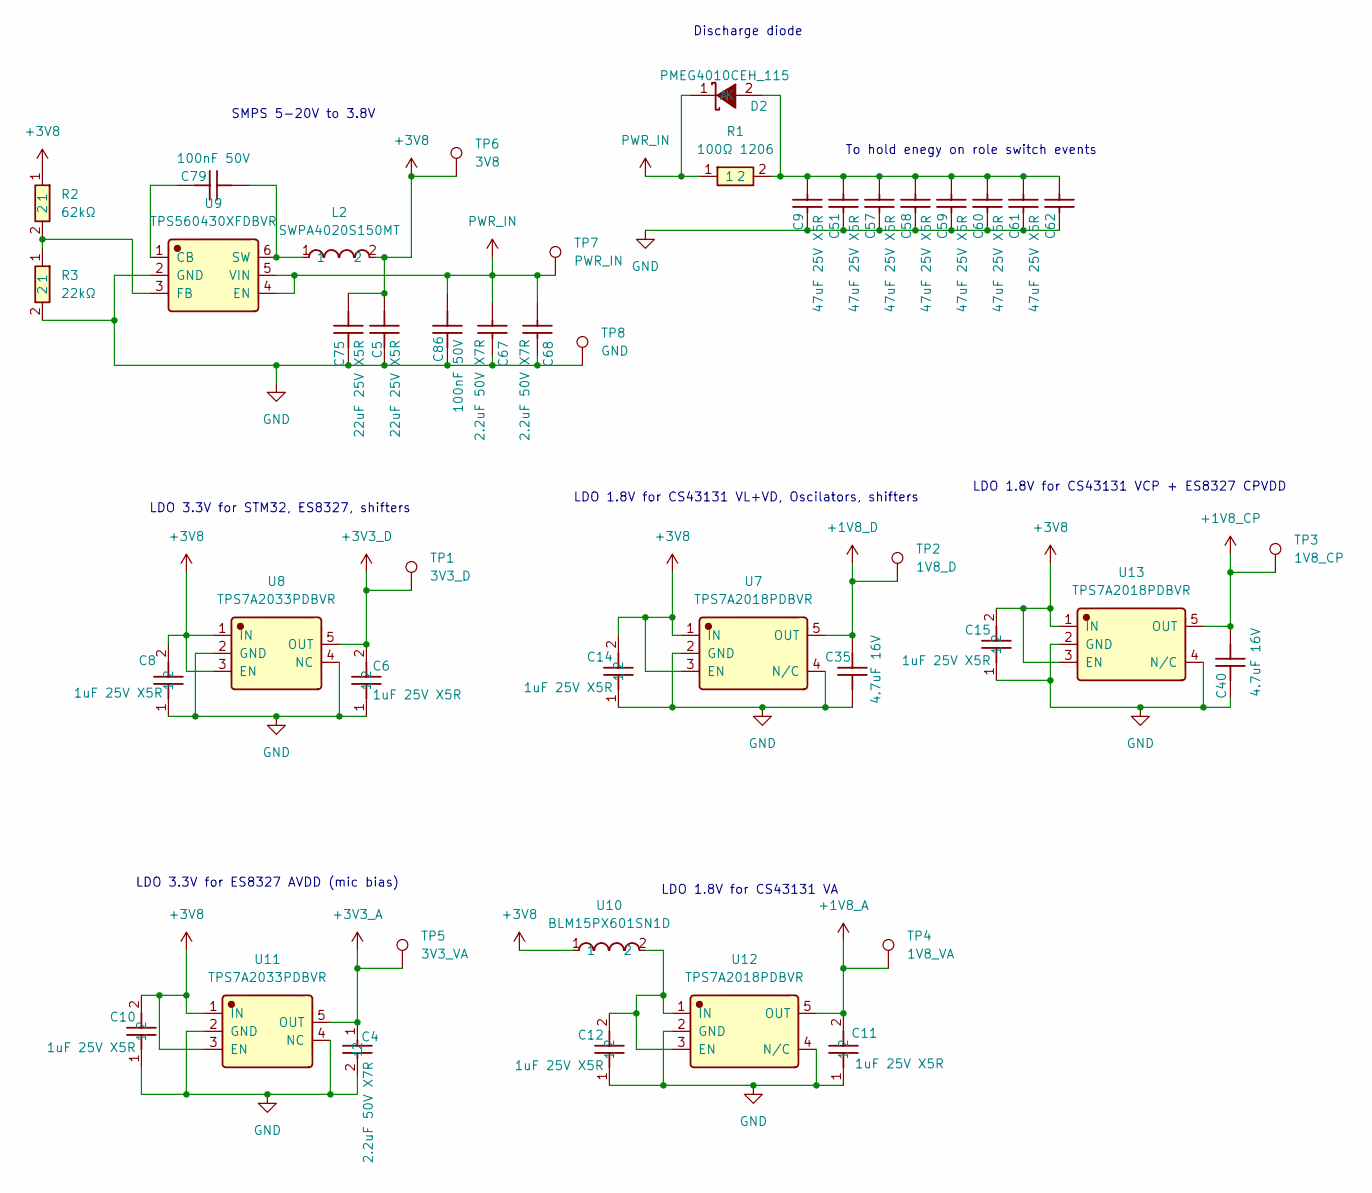
[picture p12: schematic power.kicad_sch]

Parts:
C4: 2.2uF 50V X7R; CC0805KKX7R9BB225; Manufacturer Part CC0805KKX7R9BB225; LCSC C125847
C5, C75: 22uF 25V X5R; CL21A226MAQNNNE; Manufacturer Part CL21A226MAQNNNE; LCSC C45783
C6, C8, C10, C11, C12, C14, C15: 1uF 25V X5R; CL05A105KA5NQNC; Manufacturer Part CL05A105KA5NQNC; LCSC C52923
C9, C51, C57, C58, C59, C60, C61, C62: 47uF 25V X5R; C_1206_3216Metric; Manufacturer Part C3216X5R1E476MTJ00E; LCSC C76659
C35, C40: 4.7uF 16V; C_0603_1608Metric; Manufacturer Part CL10A475KO8NNNC; LCSC C19666
C67, C68: 2.2uF 50V X7R; C_1206_3216Metric; Manufacturer Part CL31B225KBHNNNE; LCSC C50254
C79, C86: 100nF 50V; C_0402_1005Metric; Manufacturer Part CL05B104KB54PNC; LCSC C307331
D2: PMEG4010CEH_115; D_SOD-123F; Manufacturer Part PMEG4010CEH,115; LCSC C193342
L2: SWPA4020S150MT; Manufacturer Part SWPA4020S150MT; LCSC C36407
R1: 100Ω 1206; R_1206_3216Metric; Manufacturer Part SR1206JR-7W100RL; LCSC C874066
R2: 62kΩ; 0402WGF6202TCE; Manufacturer Part 0402WGF6202TCE; LCSC C37825
R3: 22kΩ; 0402WGF2202TCE; Manufacturer Part 0402WGF2202TCE; LCSC C25768
TP1: 3V3_D; TestPoint_Pad_1.0x1.0mm
TP2: 1V8_D; TestPoint_Pad_1.0x1.0mm
TP3: 1V8_CP; TestPoint_Pad_1.0x1.0mm
TP4: 1V8_VA; TestPoint_Pad_1.0x1.0mm
TP5: 3V3_VA; TestPoint_Pad_1.0x1.0mm
TP6: 3V8; TestPoint_Pad_1.0x1.0mm
TP7: PWR_IN; TestPoint_Pad_1.0x1.0mm
TP8: GND; TestPoint_Pad_1.0x1.0mm
U7, U12, U13: TPS7A2018PDBVR; Manufacturer Part TPS7A2018PDBVR; LCSC C963430
U8, U11: TPS7A2033PDBVR; Manufacturer Part TPS7A2033PDBVR; LCSC C2862740
U9: TPS560430XFDBVR; Manufacturer Part TPS560430XFDBVR; LCSC C523980
U10: BLM15PX601SN1D; Manufacturer Part BLM15PX601SN1D; LCSC C160977

Connections:
+1V8_A: C11.2, TP4.1 (1_1), U12.5 (OUT); also elsewhere on the board
+1V8_CP: C40.2, TP3.1 (1_1), U13.5 (OUT); also elsewhere on the board
+1V8_D: C35.2, TP2.1 (1_1), U7.5 (OUT); also elsewhere on the board
+3V3_A: C4.1, TP5.1 (1_1), U11.5 (OUT); also elsewhere on the board
+3V3_D: C6.2, TP1.1 (1_1), U8.5 (OUT); also elsewhere on the board
+3V8: C5.1, C8.2, C10.2, C14.2, C15.2, C75.1, L2.2, R2.1, TP6.1 (1_1), U7.1 (IN), U7.3 (EN), U8.1 (IN), U8.3 (EN), U10.1, U11.1 (IN), U11.3 (EN), U13.1 (IN), U13.3 (EN); also elsewhere on the board
GND: C4.2, C5.2, C6.1, C8.1, C9.1, C10.1, C11.1, C12.1, C14.1, C15.1, C35.1, C40.1, C51.1, C57.1, C58.1, C59.1, C60.1, C61.1, C62.1, C67.1, C68.1, C75.2, C86.1, R3.2, TP8.1 (1_1), U7.2 (GND), U7.4 (N/C), U8.2 (GND), U8.4 (NC), U9.2 (GND), U11.2 (GND), U11.4 (NC), U12.2 (GND), U12.4 (N/C), U13.2 (GND), U13.4 (N/C); also elsewhere on the board
unnamed: C9.2, C51.2, C57.2, C58.2, C59.2, C60.2, C61.2, C62.2, D2.2 (A), R1.2
unnamed: C79.1, U9.1 (CB)
unnamed: R2.2, R3.1, U9.3 (FB)
unnamed: C79.2, L2.1, U9.6 (SW)
unnamed: C12.2, U10.2, U12.1 (IN), U12.3 (EN)
PWR_IN: C67.2, C68.2, C86.2, D2.1 (K), R1.1, TP7.1 (1_1), U9.4 (EN), U9.5 (VIN); also elsewhere on the board

Notes on the sheet:
LDO 1.8V for CS43131 VCP + ES8327 CPVDD
LDO 3.3V for STM32, ES8327, shifters
To hold enegy on role switch events
LDO 3.3V for ES8327 AVDD (mic bias)
Discharge diode
LDO 1.8V for CS43131 VL+VD, Oscilators, shifters
LDO 1.8V for CS43131 VA
SMPS 5-20V to 3.8V
