drunkbatya/DrunkHeadphonesAdapter/hardware/d1/DrunkEarPhoneAdapter.kicad_pcb

## KiCad design hardware/d1/DrunkEarPhoneAdapter.kicad_pcb (continued)

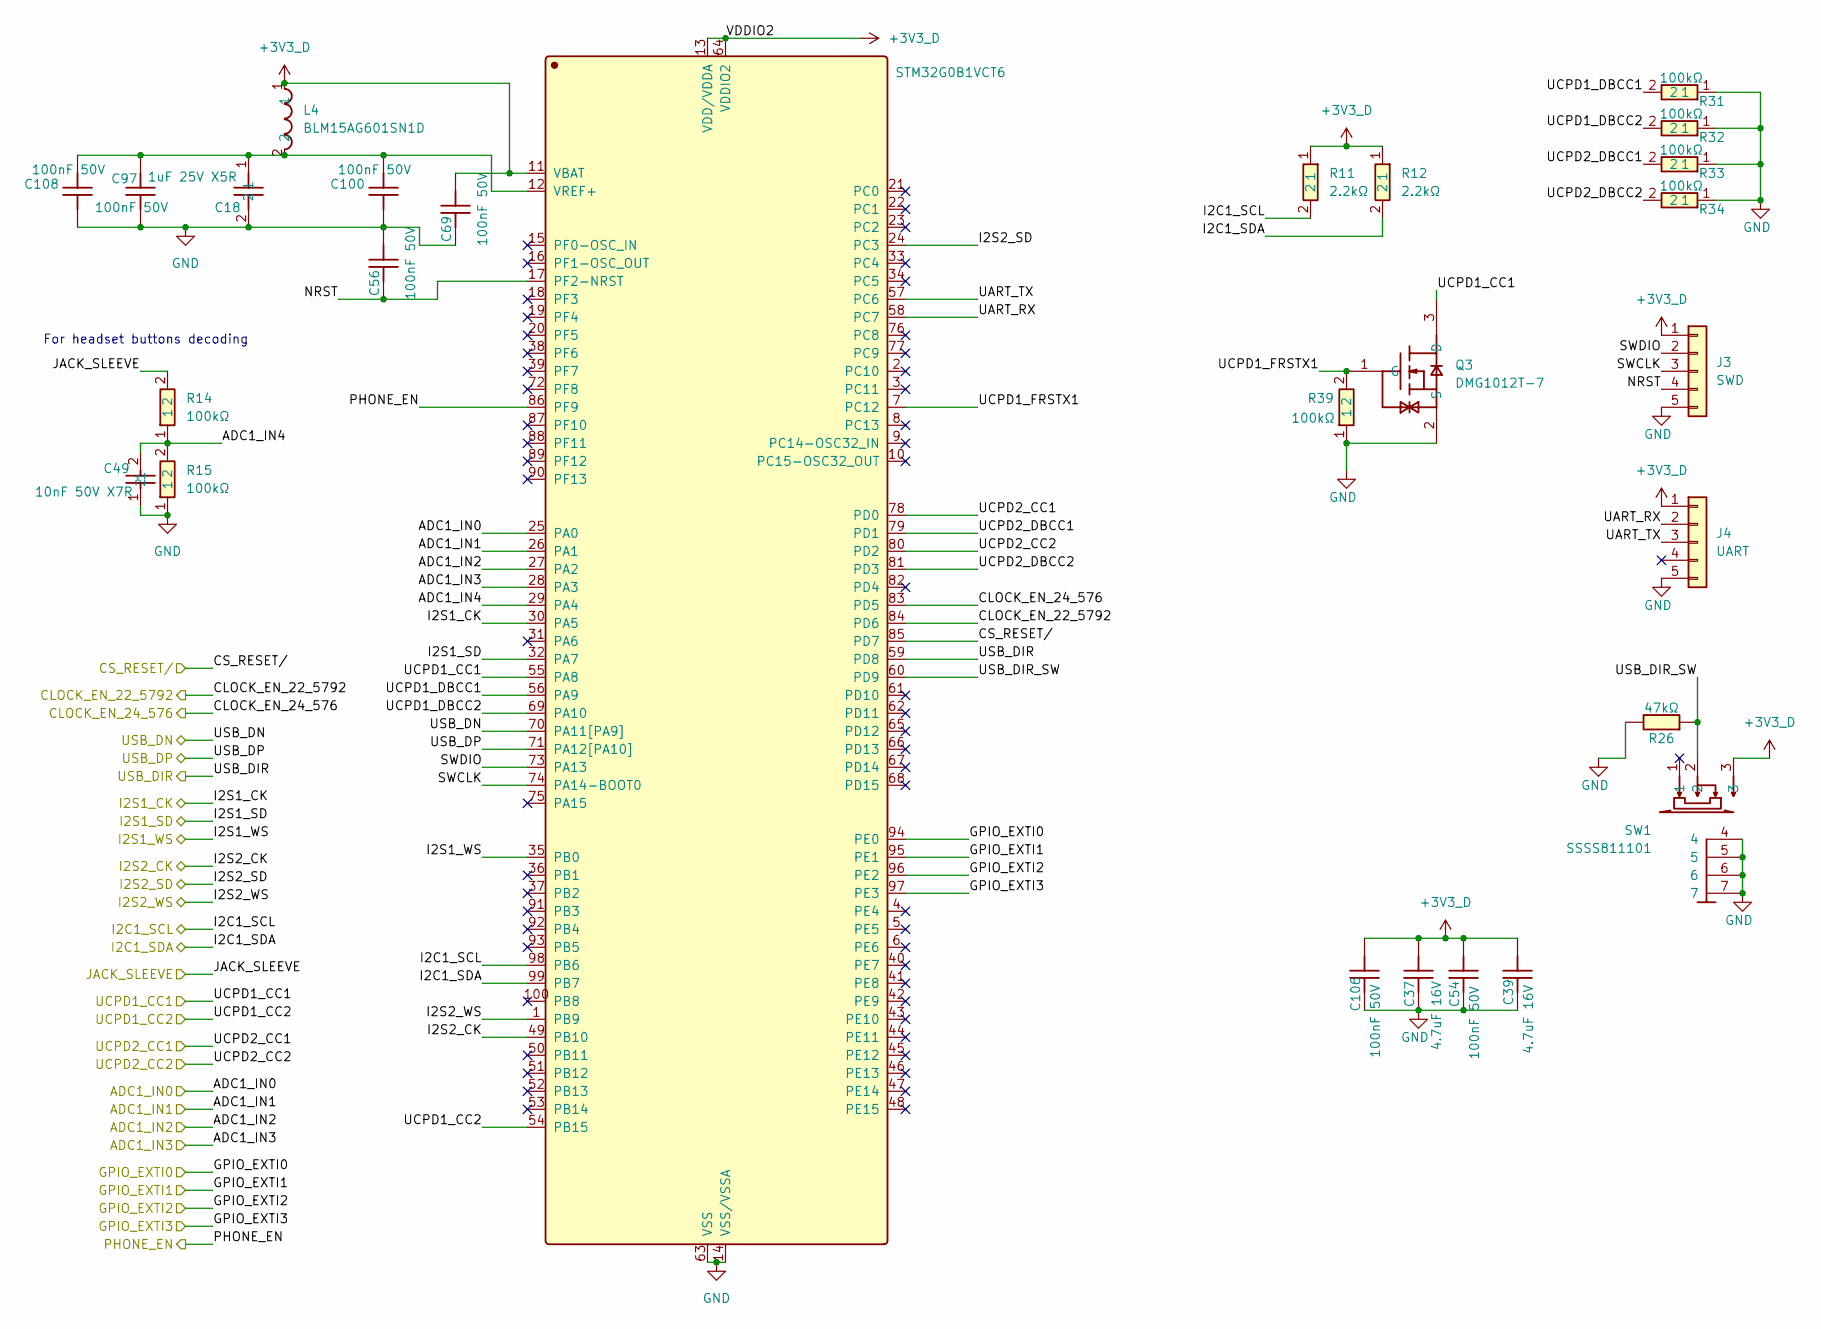
[picture p13: schematic mcu.kicad_sch]

Parts:
C18: 1uF 25V X5R; CL05A105KA5NQNC; Manufacturer Part CL05A105KA5NQNC; LCSC C52923
C37, C39: 4.7uF 16V; C_0603_1608Metric; Manufacturer Part CL10A475KO8NNNC; LCSC C19666
C49: 10nF 50V X7R; C_0402_1005Metric; Manufacturer Part CL05B103KB5NNNC; LCSC C15195
C54, C56, C69, C97, C100, C106, C108: 100nF 50V; C_0402_1005Metric; Manufacturer Part CL05B104KB54PNC; LCSC C307331
J3: SWD; Conn_1x5_1.27
J4: UART; Conn_1x5_1.27
L4: BLM15AG601SN1D; Manufacturer Part BLM15AG601SN1D; LCSC C76884
Q3: DMG1012T-7; SOT-523; Manufacturer Part DMG1012T-7; LCSC C20512
R11, R12: 2.2kΩ; R_0402_1005Metric; Manufacturer Part 0402WGF2201TCE; LCSC C25879
R14, R15, R31, R32, R33, R34, R39: 100kΩ; 0402WGF1003TCE; Manufacturer Part 0402WGF1003TCE; LCSC C25741
R26: 47kΩ; R_0402_1005Metric; Manufacturer Part 0402WGF4702TCE; LCSC C25792
SW1: SSSS811101; Manufacturer Part SSSS811101; LCSC C109335
U2: STM32G0B1VCT6; Manufacturer Part STM32G0B1VCT6; LCSC C3446137

Connections:
+3V3_D: C37.2, C39.2, C54.2, C69.2, C106.2, J3.1, J4.1, L4.1, R11.1, R12.1, SW1.3, U2.11 (VBAT), U2.13 (VDD/VDDA), U2.64 (VDDIO2); also elsewhere on the board
/adc/GMS1: R14.2; also elsewhere on the board
/adc/I2C_SCL: R11.2, U2.98 (PB6); also elsewhere on the board
/adc/I2C_SDA: R12.2, U2.99 (PB7); also elsewhere on the board
/adc/I2S_CK: U2.49 (PB10); also elsewhere on the board
/adc/I2S_SD: U2.24 (PC3); also elsewhere on the board
/adc/I2S_WS: U2.1 (PB9); also elsewhere on the board
/adc/INT/: U2.95 (PE1); also elsewhere on the board
/dac/CLOCK_EN_22_5792: U2.84 (PD6); also elsewhere on the board
/dac/CLOCK_EN_24_576: U2.83 (PD5); also elsewhere on the board
/dac/DAC_RESET/: U2.85 (PD7); also elsewhere on the board
/dac/I2S_CK: U2.30 (PA5); also elsewhere on the board
/dac/I2S_SD: U2.32 (PA7); also elsewhere on the board
/dac/I2S_WS: U2.35 (PB0); also elsewhere on the board
/dac//INT: U2.94 (PE0); also elsewhere on the board
/mcu/ADC1_IN0: U2.25 (PA0); also elsewhere on the board
/mcu/ADC1_IN1: U2.26 (PA1); also elsewhere on the board
/mcu/ADC1_IN2: U2.27 (PA2); also elsewhere on the board
/mcu/ADC1_IN3: U2.28 (PA3); also elsewhere on the board
/mcu/ADC1_IN4: C49.2, R14.1, R15.2, U2.29 (PA4)
/mcu/GPIO_EXTI2: U2.96 (PE2); also elsewhere on the board
/mcu/GPIO_EXTI3: U2.97 (PE3); also elsewhere on the board
/mcu/NRST: C56.1, J3.4, U2.17 (PF2-NRST)
/mcu/PHONE_EN: U2.86 (PF9); also elsewhere on the board
/mcu/SWCLK: J3.3, U2.74 (PA14-BOOT0)
/mcu/SWDIO: J3.2, U2.73 (PA13)
/mcu/UART_RX: J4.2, U2.58 (PC7)
/mcu/UART_TX: J4.3, U2.57 (PC6)
/mcu/UCPD1_CC1: Q3.3 (D), U2.55 (PA8); also elsewhere on the board
/mcu/UCPD1_CC2: U2.54 (PB15); also elsewhere on the board
/mcu/UCPD1_DBCC1: R31.2, U2.56 (PA9)
/mcu/UCPD1_DBCC2: R32.2, U2.69 (PA10)
/mcu/UCPD1_FRSTX1: Q3.1 (G), R39.2, U2.7 (PC12)
/mcu/UCPD2_CC1: U2.78 (PD0); also elsewhere on the board
/mcu/UCPD2_CC2: U2.80 (PD2); also elsewhere on the board
/mcu/UCPD2_DBCC1: R33.2, U2.79 (PD1)
/mcu/UCPD2_DBCC2: R34.2, U2.81 (PD3)
/mcu/USB_DIR: U2.59 (PD8); also elsewhere on the board
/mcu/USB_DIR_SW: R26.1, SW1.2, U2.60 (PD9)
/mcu/USB_DN: U2.70 (PA11[PA9]); also elsewhere on the board
/mcu/USB_DP: U2.71 (PA12[PA10]); also elsewhere on the board
GND: C18.2, C37.1, C39.1, C49.1, C54.1, C56.2, C69.1, C97.1, C100.1, C106.1, C108.1, J3.5, J4.5, Q3.2 (S), R15.1, R26.2, R31.1, R32.1, R33.1, R34.1, R39.1, SW1.4, SW1.5, SW1.6, SW1.7, U2.14 (VSS/VSSA), U2.63 (VSS); also elsewhere on the board
unnamed: C18.1, C97.2, C100.2, C108.2, L4.2, U2.12 (VREF+)

Notes on the sheet:
For headset buttons decoding

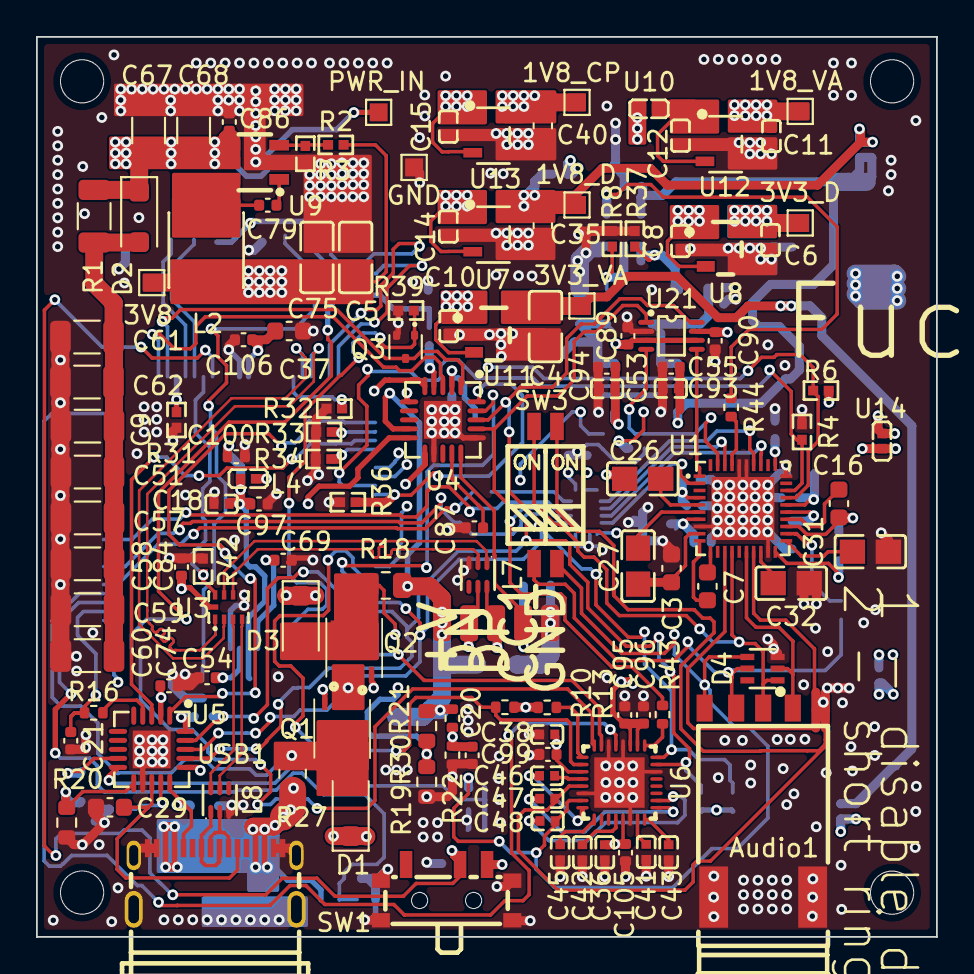
[picture p14: board DrunkEarPhoneAdapter.kicad_pcb from above]

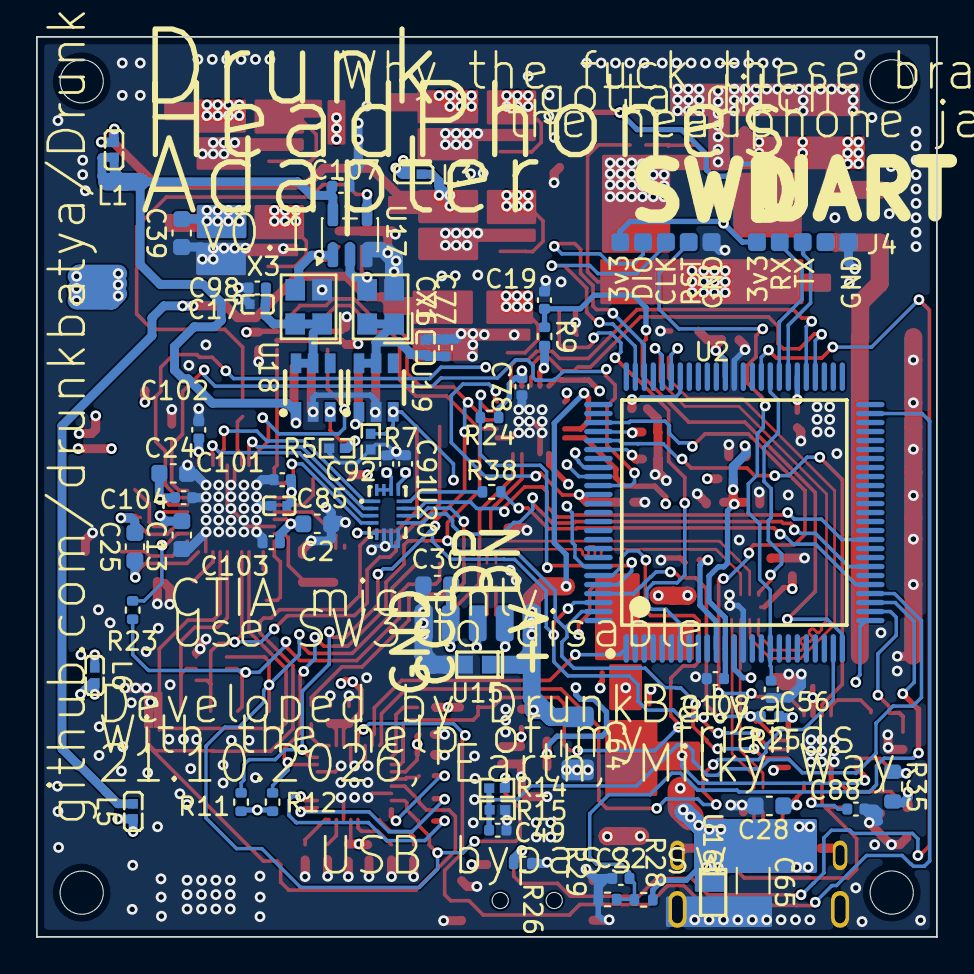
[picture p15: board DrunkEarPhoneAdapter.kicad_pcb from below]

Board: 4 copper layers, 50.0 x 50.0 mm, 188 parts (59 on the bottom side), 124 nets.
