drunkbatya/DrunkHeadphonesAdapter/software/targets/d1/stm/DrunkHeadphonesAdapter.ioc

Mcu.UserName=STM32G0B1VCTx
PA0.Signal=ADC1_IN0
PA1.Signal=ADC1_IN1
PA13.Signal=SYS_SWDIO
PA14-BOOT0.Signal=SYS_SWCLK
PA2.Signal=ADC1_IN2
PA3.Signal=ADC1_IN3
PA4.Signal=ADC1_IN4
PA5.Signal=I2S1_CK
PA7.Signal=I2S1_SD
PA8.Signal=UCPD1_CC1
PB0.Signal=I2S1_WS
PB10.Signal=I2S2_CK
PB12.Signal=UCPD2_FRSTX1
PB14.Signal=UCPD1_FRSTX2
PB15.Signal=UCPD1_CC2
PB6.Signal=I2C1_SCL
PB7.Signal=I2C1_SDA
PB9.Signal=I2S2_WS
PC12.Signal=UCPD1_FRSTX1
PC3.Signal=I2S2_SD
PC6.Signal=LPUART2_TX
PC7.Signal=LPUART2_RX
PC8.Signal=UCPD2_FRSTX2
PD0.Signal=UCPD2_CC1
PD2.Signal=UCPD2_CC2
PD5.GPIO_Label=CLK_EN1
PD5.Signal=GPIO_Output
PD6.GPIO_Label=CLK_EN2
PD6.Signal=GPIO_Output
PD7.GPIO_Label=CS_RESET/
PD7.Signal=GPIO_Output
PD8.GPIO_Label=USB_DIR
PD8.Signal=GPIO_Output
PD9.GPIO_Label=USB_DIR_SW
PD9.Signal=GPIO_Input
PE0.Signal=GPXTI0
PE1.Signal=GPXTI1
PE2.Signal=GPXTI2
PE3.Signal=GPXTI3
PF9.GPIO_Label=PHONE_EN
PF9.Signal=GPIO_Output
