drunkbatya/DrunkHeadphonesAdapter/software/targets/d1/stm/Core/Inc/main.h

#define USB_DIR_Pin LL_GPIO_PIN_8
#define USB_DIR_GPIO_Port GPIOD
#define USB_DIR_SW_Pin LL_GPIO_PIN_9
#define USB_DIR_SW_GPIO_Port GPIOD
#define CLK_EN1_Pin LL_GPIO_PIN_5
#define CLK_EN1_GPIO_Port GPIOD
#define CLK_EN2_Pin LL_GPIO_PIN_6
#define CLK_EN2_GPIO_Port GPIOD
#define CS_RESET__Pin LL_GPIO_PIN_7
#define CS_RESET__GPIO_Port GPIOD
#define PHONE_EN_Pin LL_GPIO_PIN_9
#define PHONE_EN_GPIO_Port GPIOF
