drunkbatya/DrunkHeadphonesAdapter/software/src/targets/d1/inc/tusb_config.h

#pragma once

#define CFG_TUSB_MCU OPT_MCU_STM32G0
#define CFG_TUSB_OS  OPT_OS_NONE

#define CFG_TUD_ENABLED        1
#define CFG_TUD_MAX_SPEED      OPT_MODE_FULL_SPEED
#define CFG_TUD_ENDPOINT0_SIZE 64

#define CFG_TUD_AUDIO 1
#define CFG_TUD_HID   1
#define CFG_TUD_CDC   1

#define FURI_HAL_USB_AUDIO_SPEAKER_CHANNELS        2
#define FURI_HAL_USB_AUDIO_SPEAKER_MAX_SAMPLE_RATE 96000
#define FURI_HAL_USB_AUDIO_MIC_CHANNELS            1
#define FURI_HAL_USB_AUDIO_MIC_MAX_SAMPLE_RATE     48000
#define FURI_HAL_USB_AUDIO_16BIT_SUBSLOT_SIZE      2
#define FURI_HAL_USB_AUDIO_16BIT_RESOLUTION        16
#define FURI_HAL_USB_AUDIO_24BIT_SUBSLOT_SIZE      3
#define FURI_HAL_USB_AUDIO_24BIT_RESOLUTION        24
#define FURI_HAL_USB_AUDIO_FEEDBACK_EP_SIZE        3
#define FURI_HAL_USB_AUDIO_FIFO_PACKET_COUNT       4

#define FURI_HAL_USB_AUDIO_SPEAKER_16BIT_EP_SIZE    \
    TUD_AUDIO_EP_SIZE(                              \
        false,                                      \
        FURI_HAL_USB_AUDIO_SPEAKER_MAX_SAMPLE_RATE, \
        FURI_HAL_USB_AUDIO_16BIT_SUBSLOT_SIZE,      \
        FURI_HAL_USB_AUDIO_SPEAKER_CHANNELS)
#define FURI_HAL_USB_AUDIO_SPEAKER_24BIT_EP_SIZE    \
    TUD_AUDIO_EP_SIZE(                              \
        false,                                      \
        FURI_HAL_USB_AUDIO_SPEAKER_MAX_SAMPLE_RATE, \
        FURI_HAL_USB_AUDIO_24BIT_SUBSLOT_SIZE,      \
        FURI_HAL_USB_AUDIO_SPEAKER_CHANNELS)
#define FURI_HAL_USB_AUDIO_MIC_16BIT_EP_SIZE    \
    TUD_AUDIO_EP_SIZE(                          \
        false,                                  \
        FURI_HAL_USB_AUDIO_MIC_MAX_SAMPLE_RATE, \
        FURI_HAL_USB_AUDIO_16BIT_SUBSLOT_SIZE,  \
        FURI_HAL_USB_AUDIO_MIC_CHANNELS)
#define FURI_HAL_USB_AUDIO_MIC_24BIT_EP_SIZE    \
    TUD_AUDIO_EP_SIZE(                          \
        false,                                  \
        FURI_HAL_USB_AUDIO_MIC_MAX_SAMPLE_RATE, \
        FURI_HAL_USB_AUDIO_24BIT_SUBSLOT_SIZE,  \
        FURI_HAL_USB_AUDIO_MIC_CHANNELS)

#define CFG_TUD_AUDIO_ENABLE_EP_OUT       1
#define CFG_TUD_AUDIO_ENABLE_EP_IN        1
#define CFG_TUD_AUDIO_ENABLE_FEEDBACK_EP  1
#define CFG_TUD_AUDIO_ENABLE_INTERRUPT_EP 1

#define CFG_TUD_AUDIO_FUNC_1_EP_OUT_SZ_MAX FURI_HAL_USB_AUDIO_SPEAKER_24BIT_EP_SIZE
#define CFG_TUD_AUDIO_FUNC_1_EP_OUT_SW_BUF_SZ \
    (FURI_HAL_USB_AUDIO_FIFO_PACKET_COUNT * CFG_TUD_AUDIO_FUNC_1_EP_OUT_SZ_MAX)
#define CFG_TUD_AUDIO_FUNC_1_EP_IN_SZ_MAX FURI_HAL_USB_AUDIO_MIC_24BIT_EP_SIZE
#define CFG_TUD_AUDIO_FUNC_1_EP_IN_SW_BUF_SZ \
    (FURI_HAL_USB_AUDIO_FIFO_PACKET_COUNT * CFG_TUD_AUDIO_FUNC_1_EP_IN_SZ_MAX)

#define CFG_TUD_HID_EP_BUFSIZE 8

#define CFG_TUD_CDC_EP_BUFSIZE                       64
#define CFG_TUD_CDC_RX_BUFSIZE                       CFG_TUD_CDC_EP_BUFSIZE
#define CFG_TUD_CDC_TX_BUFSIZE                       CFG_TUD_CDC_EP_BUFSIZE
#define CFG_TUD_CDC_TX_OVERWRITABLE_IF_NOT_CONNECTED 0
