drunkbatya/DrunkHeadphonesAdapter/software/src/furi/core/log.c

#include "log.h"
#include "check.h"
#include "mutex.h"
#include <furi_hal.h>
#include <m-list.h>

M_LIST_DEF(FuriLogHandlersList, FuriLogHandler, M_POD_OPLIST)

#ifdef FURI_DEBUG
#define FURI_LOG_LEVEL_DEFAULT FuriLogLevelDebug
#else
#define FURI_LOG_LEVEL_DEFAULT FuriLogLevelNone
#endif

typedef struct {
    FuriLogLevel log_level;
    FuriMutex* mutex;
    FuriLogHandlersList_t tx_handlers;
} FuriLogParams;

static FuriLogParams furi_log = {0};

typedef struct {
    const char* str;
    FuriLogLevel level;
} FuriLogLevelDescription;

static const FuriLogLevelDescription FURI_LOG_LEVEL_DESCRIPTIONS[] = {
    {"default", FuriLogLevelDefault},
    {"none", FuriLogLevelNone},
    {"error", FuriLogLevelError},
    {"warn", FuriLogLevelWarn},
    {"info", FuriLogLevelInfo},
    {"debug", FuriLogLevelDebug},
    {"trace", FuriLogLevelTrace},
};

void furi_log_init(void) {
    // Set default logging parameters
    furi_log.log_level = FURI_LOG_LEVEL_DEFAULT;
    furi_log.mutex = furi_mutex_alloc(FuriMutexTypeRecursive);
    FuriLogHandlersList_init(furi_log.tx_handlers);
}

bool furi_log_add_handler(FuriLogHandler handler) {
    furi_check(handler.callback);

    bool ret = true;

    furi_check(furi_mutex_acquire(furi_log.mutex, FuriWaitForever) == FuriStatusOk);

    FuriLogHandlersList_it_t it;
    FuriLogHandlersList_it(it, furi_log.tx_handlers);
    while(!FuriLogHandlersList_end_p(it)) {
        if(memcmp(FuriLogHandlersList_ref(it), &handler, sizeof(FuriLogHandler)) == 0) {
            ret = false;
        } else {
            FuriLogHandlersList_next(it);
        }
    }

    if(ret) {
        FuriLogHandlersList_push_back(furi_log.tx_handlers, handler);
    }

    furi_mutex_release(furi_log.mutex);

    return ret;
}

bool furi_log_remove_handler(FuriLogHandler handler) {
    bool ret = false;

    furi_check(furi_mutex_acquire(furi_log.mutex, FuriWaitForever) == FuriStatusOk);

    FuriLogHandlersList_it_t it;
    FuriLogHandlersList_it(it, furi_log.tx_handlers);
    while(!FuriLogHandlersList_end_p(it)) {
        if(memcmp(FuriLogHandlersList_ref(it), &handler, sizeof(FuriLogHandler)) == 0) {
            FuriLogHandlersList_remove(furi_log.tx_handlers, it);
            ret = true;
        } else {
            FuriLogHandlersList_next(it);
        }
    }

    furi_mutex_release(furi_log.mutex);

    return ret;
}

void furi_log_tx(const uint8_t* data, size_t size) {
    if(!FURI_IS_ISR()) {
        furi_check(furi_mutex_acquire(furi_log.mutex, FuriWaitForever) == FuriStatusOk);
    } else {
        if(furi_mutex_get_owner(furi_log.mutex)) return;
    }

    FuriLogHandlersList_it_t it;
    FuriLogHandlersList_it(it, furi_log.tx_handlers);
    while(!FuriLogHandlersList_end_p(it)) {
        FuriLogHandlersList_ref(it)->callback(data, size, FuriLogHandlersList_ref(it)->context);
        FuriLogHandlersList_next(it);
    }

    if(!FURI_IS_ISR()) furi_mutex_release(furi_log.mutex);
}

void furi_log_puts(const char* data) {
    furi_check(data);
    furi_log_tx((const uint8_t*)data, strlen(data));
}

void furi_log_print_format(FuriLogLevel level, const char* tag, const char* format, ...) {
    do {
        if(level > furi_log.log_level) {
            break;
        }

        if(furi_mutex_acquire(furi_log.mutex, furi_kernel_is_running() ? FuriWaitForever : 0) !=
           FuriStatusOk) {
            break;
        }

        FuriString* string = furi_string_alloc();

        const char* color = _FURI_LOG_CLR_RESET;
        const char* log_letter = " ";
        switch(level) {
        case FuriLogLevelError:
            color = _FURI_LOG_CLR_E;
            log_letter = "E";
            break;
        case FuriLogLevelWarn:
            color = _FURI_LOG_CLR_W;
            log_letter = "W";
            break;
        case FuriLogLevelInfo:
            color = _FURI_LOG_CLR_I;
            log_letter = "I";
            break;
        case FuriLogLevelDebug:
            color = _FURI_LOG_CLR_D;
            log_letter = "D";
            break;
        case FuriLogLevelTrace:
            color = _FURI_LOG_CLR_T;
            log_letter = "T";
            break;
        default:
            break;
        }

        // Timestamp
        furi_string_printf(
            string, "%lu %s[%s][%s] " _FURI_LOG_CLR_RESET, furi_get_tick(), color, log_letter, tag);
        furi_log_puts(furi_string_get_cstr(string));
        furi_string_reset(string);

        va_list args;
        va_start(args, format);
        furi_string_vprintf(string, format, args);
        va_end(args);

        furi_log_puts(furi_string_get_cstr(string));
        furi_string_free(string);

        furi_log_puts("\r\n");

        furi_mutex_release(furi_log.mutex);
    } while(0);
}

void furi_log_print_raw_format(FuriLogLevel level, const char* format, ...) {
    if(level <= furi_log.log_level &&
       furi_mutex_acquire(furi_log.mutex, FuriWaitForever) == FuriStatusOk) {
        FuriString* string;
        string = furi_string_alloc();
        va_list args;
        va_start(args, format);
        furi_string_vprintf(string, format, args);
        va_end(args);

        furi_log_puts(furi_string_get_cstr(string));
        furi_string_free(string);

        furi_mutex_release(furi_log.mutex);
    }
}

void furi_log_set_level(FuriLogLevel level) {
    furi_check(level <= FuriLogLevelTrace);

    if(level == FuriLogLevelDefault) {
        level = FURI_LOG_LEVEL_DEFAULT;
    }
    furi_log.log_level = level;
}

FuriLogLevel furi_log_get_level(void) {
    return furi_log.log_level;
}

bool furi_log_level_to_string(FuriLogLevel level, const char** str) {
    for(size_t i = 0; i < COUNT_OF(FURI_LOG_LEVEL_DESCRIPTIONS); i++) {
        if(level == FURI_LOG_LEVEL_DESCRIPTIONS[i].level) {
            *str = FURI_LOG_LEVEL_DESCRIPTIONS[i].str;
            return true;
        }
    }
    return false;
}

bool furi_log_level_from_string(const char* str, FuriLogLevel* level) {
    for(size_t i = 0; i < COUNT_OF(FURI_LOG_LEVEL_DESCRIPTIONS); i++) {
        if(strcmp(str, FURI_LOG_LEVEL_DESCRIPTIONS[i].str) == 0) {
            *level = FURI_LOG_LEVEL_DESCRIPTIONS[i].level;
            return true;
        }
    }
    return false;
}
