drunkbatya/DrunkHeadphonesAdapter/software/src/furi/core/stream_buffer.c

#include "stream_buffer.h"

#include <FreeRTOS.h>
#include <stream_buffer.h>

#include "check.h"
#include "common_defines.h"

#include "event_loop_link_i.h"

// Internal FreeRTOS member names
#define xTriggerLevelBytes uxDummy1[3]

struct FuriStreamBuffer {
    StaticStreamBuffer_t container;
    FuriEventLoopLink event_loop_link;
    uint8_t buffer[];
};

// IMPORTANT: container MUST be the FIRST struct member
static_assert(offsetof(FuriStreamBuffer, container) == 0);
// IMPORTANT: buffer MUST be the LAST struct member
static_assert(offsetof(FuriStreamBuffer, buffer) == sizeof(FuriStreamBuffer));

FuriStreamBuffer* furi_stream_buffer_alloc(size_t size, size_t trigger_level) {
    furi_check(size != 0);

    // Actual FreeRTOS usable buffer size seems to be one less
    const size_t buffer_size = size + 1;

    FuriStreamBuffer* stream_buffer = malloc(sizeof(FuriStreamBuffer) + buffer_size);
    StreamBufferHandle_t hStreamBuffer = xStreamBufferCreateStatic(
        buffer_size, trigger_level, stream_buffer->buffer, &stream_buffer->container);

    furi_check(hStreamBuffer == (StreamBufferHandle_t)stream_buffer);

    return stream_buffer;
}

void furi_stream_buffer_free(FuriStreamBuffer* stream_buffer) {
    furi_check(stream_buffer);

    // Event Loop must be disconnected
    furi_check(!stream_buffer->event_loop_link.item_in);
    furi_check(!stream_buffer->event_loop_link.item_out);

    vStreamBufferDelete((StreamBufferHandle_t)stream_buffer);
    free(stream_buffer);
}

bool furi_stream_set_trigger_level(FuriStreamBuffer* stream_buffer, size_t trigger_level) {
    furi_check(stream_buffer);
    return xStreamBufferSetTriggerLevel((StreamBufferHandle_t)stream_buffer, trigger_level) ==
           pdTRUE;
}

size_t furi_stream_get_trigger_level(FuriStreamBuffer* stream_buffer) {
    furi_check(stream_buffer);
    return ((StaticStreamBuffer_t*)stream_buffer)->xTriggerLevelBytes;
}

size_t furi_stream_buffer_send(
    FuriStreamBuffer* stream_buffer,
    const void* data,
    size_t length,
    uint32_t timeout) {
    furi_check(stream_buffer);

    size_t ret;

    if(FURI_IS_IRQ_MODE()) {
        BaseType_t yield;
        ret = xStreamBufferSendFromISR((StreamBufferHandle_t)stream_buffer, data, length, &yield);
        portYIELD_FROM_ISR(yield);
    } else {
        ret = xStreamBufferSend((StreamBufferHandle_t)stream_buffer, data, length, timeout);
    }

    if(ret > 0) {
        const size_t bytes_available =
            xStreamBufferBytesAvailable((StreamBufferHandle_t)stream_buffer);
        const size_t trigger_level = ((StaticStreamBuffer_t*)stream_buffer)->xTriggerLevelBytes;

        if(bytes_available >= trigger_level) {
            furi_event_loop_link_notify(&stream_buffer->event_loop_link, FuriEventLoopEventIn);
        }
    }

    return ret;
}

size_t furi_stream_buffer_receive(
    FuriStreamBuffer* stream_buffer,
    void* data,
    size_t length,
    uint32_t timeout) {
    furi_check(stream_buffer);

    size_t ret;

    if(FURI_IS_IRQ_MODE()) {
        BaseType_t yield;
        ret =
            xStreamBufferReceiveFromISR((StreamBufferHandle_t)stream_buffer, data, length, &yield);
        portYIELD_FROM_ISR(yield);
    } else {
        ret = xStreamBufferReceive((StreamBufferHandle_t)stream_buffer, data, length, timeout);
    }

    if(ret > 0) {
        furi_event_loop_link_notify(&stream_buffer->event_loop_link, FuriEventLoopEventOut);
    }

    return ret;
}

size_t furi_stream_buffer_bytes_available(FuriStreamBuffer* stream_buffer) {
    furi_check(stream_buffer);

    return xStreamBufferBytesAvailable((StreamBufferHandle_t)stream_buffer);
}

size_t furi_stream_buffer_spaces_available(FuriStreamBuffer* stream_buffer) {
    furi_check(stream_buffer);

    return xStreamBufferSpacesAvailable((StreamBufferHandle_t)stream_buffer);
}

bool furi_stream_buffer_is_full(FuriStreamBuffer* stream_buffer) {
    furi_check(stream_buffer);

    return xStreamBufferIsFull((StreamBufferHandle_t)stream_buffer) == pdTRUE;
}

bool furi_stream_buffer_is_empty(FuriStreamBuffer* stream_buffer) {
    furi_check(stream_buffer);

    return xStreamBufferIsEmpty((StreamBufferHandle_t)stream_buffer) == pdTRUE;
}

FuriStatus furi_stream_buffer_reset(FuriStreamBuffer* stream_buffer) {
    furi_check(stream_buffer);

    FuriStatus status;

    if(xStreamBufferReset((StreamBufferHandle_t)stream_buffer) == pdPASS) {
        status = FuriStatusOk;
    } else {
        status = FuriStatusError;
    }

    if(status == FuriStatusOk) {
        furi_event_loop_link_notify(&stream_buffer->event_loop_link, FuriEventLoopEventOut);
    }

    return status;
}

static FuriEventLoopLink* furi_stream_buffer_event_loop_get_link(FuriEventLoopObject* object) {
    FuriStreamBuffer* stream_buffer = object;
    furi_assert(stream_buffer);
    return &stream_buffer->event_loop_link;
}

static bool
    furi_stream_buffer_event_loop_get_level(FuriEventLoopObject* object, FuriEventLoopEvent event) {
    FuriStreamBuffer* stream_buffer = object;
    furi_assert(stream_buffer);

    if(event == FuriEventLoopEventIn) {
        return xStreamBufferBytesAvailable((StreamBufferHandle_t)stream_buffer);
    } else if(event == FuriEventLoopEventOut) {
        return xStreamBufferSpacesAvailable((StreamBufferHandle_t)stream_buffer);
    } else {
        furi_crash();
    }
}

const FuriEventLoopContract furi_stream_buffer_event_loop_contract = {
    .get_link = furi_stream_buffer_event_loop_get_link,
    .get_level = furi_stream_buffer_event_loop_get_level,
};
