drunkbatya/DrunkHeadphonesAdapter/software/src/targets/d1/furi_hal/furi_hal_power.c

#include <furi_hal_power.h>
#include <furi_hal_clock.h>
#include <furi_hal_bus.h>
#include <furi_hal_debug.h>
#include <furi_hal_serial_control.h>

#include <stm32g0xx_ll_rcc.h>
#include <stm32g0xx_ll_pwr.h>
#include <stm32g0xx_ll_cortex.h>

#include <furi.h>

#define TAG "FuriHalPower"

#ifndef FURI_HAL_POWER_STOP_MODE
#define FURI_HAL_POWER_STOP_MODE (LL_PWR_MODE_STOP1)
#endif

typedef struct {
    volatile uint8_t insomnia;
} FuriHalPower;

static volatile FuriHalPower furi_hal_power = {
    .insomnia = 0,
};

void furi_hal_power_init(void) {
    furi_hal_bus_enable(FuriHalBusPWR);

    LL_PWR_SetRegulVoltageScaling(LL_PWR_REGU_VOLTAGE_SCALE1);

    LL_PWR_SetPowerMode(FURI_HAL_POWER_STOP_MODE);

    FURI_LOG_I(TAG, "Init OK");
}

uint16_t furi_hal_power_insomnia_level(void) {
    return furi_hal_power.insomnia;
}

void furi_hal_power_insomnia_enter(void) {
    FURI_CRITICAL_ENTER();
    furi_check(furi_hal_power.insomnia < UINT8_MAX);
    furi_hal_power.insomnia++;
    FURI_CRITICAL_EXIT();
}

void furi_hal_power_insomnia_exit(void) {
    FURI_CRITICAL_ENTER();
    furi_check(furi_hal_power.insomnia > 0);
    furi_hal_power.insomnia--;
    FURI_CRITICAL_EXIT();
}

bool furi_hal_power_sleep_available(void) {
    return furi_hal_power.insomnia == 0;
}

static inline bool furi_hal_power_deep_sleep_available(void) {
    return !furi_hal_debug_is_gdb_session_active();
}

static inline void furi_hal_power_light_sleep(void) {
    __WFI();
}

static inline void furi_hal_power_suspend_aux_periphs(void) {
#ifdef FURI_DEBUG
    // Disable USART
    furi_hal_serial_control_suspend();
#endif
}

static inline void furi_hal_power_resume_aux_periphs(void) {
#ifdef FURI_DEBUG
    // Re-enable USART
    furi_hal_serial_control_resume();
#endif
}

static inline void furi_hal_power_deep_sleep(void) {
    furi_hal_power_suspend_aux_periphs();

    // Prepare deep sleep
    LL_LPM_EnableDeepSleep();

    __WFI();

    LL_LPM_EnableSleep();

    if(LL_RCC_GetSysClkSource() == LL_RCC_SYS_CLKSOURCE_STATUS_HSI) {
        furi_hal_clock_switch_hsi2pll();
    } else {
        furi_check(LL_RCC_GetSysClkSource() == LL_RCC_SYS_CLKSOURCE_STATUS_PLL);
    }

    furi_hal_power_resume_aux_periphs();
}

void furi_hal_power_sleep(void) {
    if(furi_hal_power_deep_sleep_available()) {
        furi_hal_power_deep_sleep();
    } else {
        furi_hal_power_light_sleep();
    }
}

FURI_NORETURN void furi_hal_power_reset(void) {
    NVIC_SystemReset();
}
