drunkbatya/DrunkHeadphonesAdapter/software/src/targets/d1/furi_hal/furi_hal_idle_timer.h

#pragma once

#include <stm32g0xx_ll_lptim.h>
#include <stm32g0xx_ll_rcc.h>
#include <stm32g0xx_ll_bus.h>

#include <furi_hal_bus.h>

// Timer used for tickless idle
#define FURI_HAL_IDLE_TIMER_MAX 0xFFFF
#define FURI_HAL_IDLE_TIMER     LPTIM1
#define FURI_HAL_IDLE_TIMER_IRQ TIM6_DAC_LPTIM1_IRQn

static inline void furi_hal_idle_timer_init(void) {
    furi_hal_bus_enable(FuriHalBusLPTIM1);
    // Configure clock source
    LL_RCC_SetLPTIMClockSource(LL_RCC_LPTIM1_CLKSOURCE_LSI);
    // There is a theoretical possibility that we need it
    LL_APB1_GRP1_EnableClockStopSleep(LL_APB1_GRP1_PERIPH_LPTIM1);
    // Set interrupt priority and enable them
    NVIC_SetPriority(
        FURI_HAL_IDLE_TIMER_IRQ, NVIC_EncodePriority(NVIC_GetPriorityGrouping(), 15, 0));
    NVIC_EnableIRQ(FURI_HAL_IDLE_TIMER_IRQ);
}

static inline void furi_hal_idle_timer_start(uint32_t count) {
    count--;
    // Enable compare match interrupt
    LL_LPTIM_EnableIT_CMPM(FURI_HAL_IDLE_TIMER);

    // Enable timer
    LL_LPTIM_Enable(FURI_HAL_IDLE_TIMER);
    while(!LL_LPTIM_IsEnabled(FURI_HAL_IDLE_TIMER))
        ;

    // Set compare, autoreload and start counter
    // Include some marging to workaround ARRM behaviour
    LL_LPTIM_ClearFlag_ARROK(FURI_HAL_IDLE_TIMER);
    LL_LPTIM_SetAutoReload(FURI_HAL_IDLE_TIMER, count);
    while(!LL_LPTIM_IsActiveFlag_ARROK(FURI_HAL_IDLE_TIMER))
        ;
    LL_LPTIM_ClearFlag_CMPOK(FURI_HAL_IDLE_TIMER);
    LL_LPTIM_SetCompare(FURI_HAL_IDLE_TIMER, count - 3);
    while(!LL_LPTIM_IsActiveFlag_CMPOK(FURI_HAL_IDLE_TIMER))
        ;
    LL_LPTIM_StartCounter(FURI_HAL_IDLE_TIMER, LL_LPTIM_OPERATING_MODE_ONESHOT);
}

static inline void furi_hal_idle_timer_reset(void) {
    // Hard reset timer
    // THE ONLY RELIABLE WAY to stop it according to errata
    furi_hal_bus_reset(FuriHalBusLPTIM1);
    // Prevent IRQ handler call
    NVIC_ClearPendingIRQ(FURI_HAL_IDLE_TIMER_IRQ);
}

static inline uint32_t furi_hal_idle_timer_get_cnt(void) {
    uint32_t counter = LL_LPTIM_GetCounter(FURI_HAL_IDLE_TIMER);
    uint32_t counter_shadow = LL_LPTIM_GetCounter(FURI_HAL_IDLE_TIMER);
    while(counter != counter_shadow) {
        counter = counter_shadow;
        counter_shadow = LL_LPTIM_GetCounter(FURI_HAL_IDLE_TIMER);
    }
    return counter;
}
