drunkbatya/DrunkHeadphonesAdapter/software/src/furi/core/memmgr.c

#include "memmgr.h"
#include <string.h>
#include <FreeRTOS.h>

extern void* pvPortMalloc(size_t xSize);
extern void vPortFree(void* pv);
extern size_t xPortGetFreeHeapSize(void);
extern size_t xPortGetTotalHeapSize(void);
extern size_t xPortGetMinimumEverFreeHeapSize(void);

void* malloc(size_t size) {
    return pvPortMalloc(size);
}

void free(void* ptr) {
    vPortFree(ptr);
}

void* realloc(void* ptr, size_t size) {
    if(size == 0) {
        vPortFree(ptr);
        return NULL;
    }

    void* p = pvPortMalloc(size);
    if(ptr != NULL) {
        memcpy(p, ptr, size);
        vPortFree(ptr);
    }

    return p;
}

void* calloc(size_t count, size_t size) {
    return pvPortMalloc(count * size);
}

char* strdup(const char* s) {
    // arg s marked as non-null, so we need hack to check for NULL
    furi_check(((uint32_t)s << 2) != 0);

    size_t siz = strlen(s) + 1;
    char* y = pvPortMalloc(siz);
    memcpy(y, s, siz);

    return y;
}

size_t memmgr_get_free_heap(void) {
    return xPortGetFreeHeapSize();
}

size_t memmgr_get_total_heap(void) {
    return configTOTAL_HEAP_SIZE;
}

size_t memmgr_get_minimum_free_heap(void) {
    return xPortGetMinimumEverFreeHeapSize();
}

void* __wrap__malloc_r(struct _reent* r, size_t size) {
    UNUSED(r);
    return pvPortMalloc(size);
}

void __wrap__free_r(struct _reent* r, void* ptr) {
    UNUSED(r);
    vPortFree(ptr);
}

void* __wrap__calloc_r(struct _reent* r, size_t count, size_t size) {
    UNUSED(r);
    return calloc(count, size);
}

void* __wrap__realloc_r(struct _reent* r, void* ptr, size_t size) {
    UNUSED(r);
    return realloc(ptr, size);
}

void* aligned_malloc(size_t size, size_t alignment) {
    void* p1; // original block
    void** p2; // aligned block
    int offset = alignment - 1 + sizeof(void*);
    if((p1 = (void*)malloc(size + offset)) == NULL) {
        return NULL;
    }
    p2 = (void**)(((size_t)(p1) + offset) & ~(alignment - 1));
    p2[-1] = p1;
    return p2;
}

void aligned_free(void* p) {
    if(p) {
        free(((void**)p)[-1]);
    }
}
