drunkbatya/DrunkHeadphonesAdapter/(commit log)

2026-09-30 Change uart pins, add components
2026-10-11 Pre power change
2026-10-14 Fix socket
2026-10-15 New switch
2026-10-20 Fix track lengths
2026-10-31 Ported furi_hal bus, clock, interrupt, os, add freertos patch
2026-11-10 Port furi_hal_adc over dma
2026-11-12 Replace tcpp03 driver, add usbc service base
2026-11-13 Fixing I2S dma sequence, remove WS waiting
2026-11-13 Fix pcb silk err
2026-11-13 Add android app board imgs
2026-11-14 Add ucpd thread
