drunkbatya/DrunkHeadphonesAdapter/(notices)

Notices in the files:
software/targets/d1/stm/USBPD/App/usbpd_pdo_defs.h:
Copyright (c) 2026 STMicroelectronics.
All rights reserved.
This software is licensed under terms that can be found in the LICENSE file
